Taiye24/Final-Year-Mechatronics-Project-478/TESTING/WETTED AREA/Wetted_Area_Test_Data_LCG560.xlsx

Sheet: Model dimensions
Model dimensions
Quantity | Value | Unit
Beam (chine) | 400 | mm
Planing length | 1600 | mm
Deadrise angle | 18 | deg
Displacement weight | 264.87 | N
Displacement mass | 27 | kg
LCG from transom (resistance and wetted-area tests) | 560 | mm
VCG above keel | 92 | mm
Tow-rod (thrust line) height above keel | 161.6 | mm
Thrust-line offset from CG (negative = above CG) | -69.6 | mm
Thrust inclination to keel | 0 | deg

Sheet: Resistance tests
Drag and trim, LCG 560 mm from transom: resistance tests (clean hull, water temperature 16.8 °C)
Run | Mean speed (m/s) | Volumetric Froude number | Drag (N) | Running trim (deg)
1 | 0.390 | 0.23 | 0.77 | 3.25
2 | 0.904 | 0.53 | 5.43 | 3.43
3 | 1.421 | 0.83 | 15.96 | 3.96
4 | 1.937 | 1.13 | 31.12 | 5.70
5 | 2.454 | 1.43 | 37.85 | 6.45
6 | 2.965 | 1.73 | 41.39 | 6.78
7 | 3.483 | 2.03 | 45.95 | 7.26
8 | 3.999 | 2.33 | 47.71 | 7.47
9 | 4.512 | 2.63 | 47.79 | 7.06
10 | 5.024 | 2.93 | 48.21 | 6.50
11 | 5.541 | 3.23 | 48.70 | 5.95
12 | 6.057 | 3.53 | 49.99 | 5.47
13 | 6.569 | 3.83 | 51.38 | 5.02
Values used
Displacement weight (N) | 264.87
Water density at 16.8 °C (kg/m³) | 998.8125 | ITTC 7.5-02-01-03 (2011)
Static floating trim (deg) | 3.2

Sheet: Wetted area tests
Wetted area, LCG 560 mm from transom (water temperature 19 °C), with drag and trim from the resistance tests (16.8 °C) at the same speed
Run | Mean speed (m/s) | Volumetric Froude number | Drag from resistance tests (N) | Running trim from resistance tests (deg) | Wetted keel length (m) | Wetted chine length (m) | Mean wetted length (m) | Rectangle b·Lc (m²) | Triangles ½b(Lk − Lc) (m²) | Plan-view wetted area (m²) | Wetted surface area (m²)
1 | 2.041 | 1.19 | 32.47 | 5.85 | 1.585 | 1.365 | 1.475 | 0.546 | 0.044 | 0.590 | 0.620
2 | 3.069 | 1.79 | 42.31 | 6.88 | 1.420 | 1.065 | 1.242 | 0.426 | 0.071 | 0.497 | 0.523
3 | 4.104 | 2.39 | 47.73 | 7.38 | 1.175 | 0.845 | 1.010 | 0.338 | 0.066 | 0.404 | 0.425
4 | 5.132 | 2.99 | 48.31 | 6.39 | 1.050 | 0.730 | 0.890 | 0.292 | 0.064 | 0.356 | 0.374
Values used
Displacement weight (N) | 264.87
Water density at 19 °C (kg/m³) | 998.4083 | ITTC 7.5-02-01-03 (2011)
Beam (m) | 0.4
Deadrise angle (deg) | 18
