Taiye24/Final-Year-Mechatronics-Project-478/SAMPLE CALCULATIONS/Calculations_Chapters_4_and_5.xlsx

Sheet: Inputs
Inputs, water properties and uncertainty parameters
Blue = input value (source in column D); black = formula.
Quantity | Value | Unit | Source
Displacement weight, W | 264.87 | N | Data_Eval workbooks, ANALYZE DATA!B33
Gravitational acceleration, g | 9.81 | m/s² | As used in the Data_Eval workbooks
Water temperature, 640 mm (Sets A–C, same day) | 15.8 | °C | Measured during testing
Water temperature, 560 and 480 mm | 16.8 | °C | Measured during testing
ITTC 7.5-02-01-03 Rev 02 (2011), Appendix A: fresh water properties used
Temperature (°C) | ρ (kg/m³) | ν (m²/s)
15.8 | 998.9783 | 1.115e-06 | ITTC 7.5-02-01-03 Rev 02 (2011), Appendix A (0.1 °C increments)
16.8 | 998.8125 | 1.0867e-06
19 | 998.4083 | 1.0283e-06
Quantity | 640 mm | 560 and 480 mm | Unit
Water density, ρ (ITTC 2011) | 998.98 | 998.81 | kg/m³
Displaced volume, ∇ = W/(ρg) (Equation 4.2) | 0.027028 | 0.027032 | m³
∇^(1/3) | 0.30010 | 0.30012 | m
Reference speed, √(g∇^(1/3)) (denominator of Equation 4.1) | 1.71581 | 1.71586 | m/s
Uncertainty inputs (Figliola & Beasley, 2019; Equations 4.5 and 4.6)
Quantity | Value | Unit | Source
Number of repeat sets, N | 3 |  | Sets A–C (Table 4.3)
Student's t, 95 %, two degrees of freedom, t95 | 4.303 |  | Student t table, ν = N − 1 = 2
Systematic term, drag | 0 | N | No confirmed load-cell accuracy (Section 4.11)
Potentiometer resolution (P25 variant) | 0.2 | mm | Micro-Epsilon (n.d.)
Attachment spacing, dpot | 1690 | mm | Data_Eval_640.xls, ANALYZE DATA!B10
Systematic term, trim: half resolution per potentiometer through Equation 4.3 | 0.0048 | deg | Calculated
Check: density to use inside the Data_Eval workbooks (ITTC 2011)
Workbook | ρ used (kg/m³) | Effect on Fn∇ | Note
Data_Eval_640.xls | 998.9783 | 0.000%
Data_Eval_560.xls and Data_Eval_480.xls | 998.8125 | 0.000%

Sheet: Table 4.4
Table 4.4: Test speeds and volumetric Froude numbers (Equation 4.1, 15.8 °C water)
V (m/s) | Fn∇ | Fn∇ as printed in Table 4.4
0.5 | 0.2914 | 0.29
1.0 | 0.5828 | 0.58
1.5 | 0.8742 | 0.87
2.0 | 1.1656 | 1.17
2.5 | 1.4570 | 1.46
3.0 | 1.7484 | 1.75
3.5 | 2.0399 | 2.04
4.0 | 2.3313 | 2.33
4.5 | 2.6227 | 2.62
5.0 | 2.9141 | 2.91
5.5 | 3.2055 | 3.21
6.0 | 3.4969 | 3.50
6.5 | 3.7883 | 3.79
Speeds are the nominal (target) test speeds; the reference speed √(g∇^(1/3)) is on the Inputs sheet.

Sheet: Table F.1
Appendix Table F.1: baseline results at LCG 640 mm, mean of three sets ± uₓ at 95 % confidence
Blue columns: measured run means from Data_Eval_640.xls, ANALYZE DATA. Speed and drag are the numbers inside the Fn∇ and D/W formulas (rows 2–3, 26–27, 49–50); trim is rows 4, 28 and 51. All other columns are formulas.
 | Speed |  |  |  |  | Drag force (N) |  |  |  |  |  |  | Running trim (deg) |  |  |  |  |  |  | As printed in Table F.1
Step | V Set A (m/s) | V Set B (m/s) | V Set C (m/s) | Mean V (m/s) | Fn∇ | F Set A | F Set B | F Set C | Mean F | s | s / √N | uₓ (95 %) | τ Set A | τ Set B | τ Set C | Mean τ | s | s / √N | uₓ (95 %) | V (m/s) | Fn∇ | F (N) | τ (deg) | u_F / mean F (%)
1 | 0.4043 | 0.4098 | 0.4115 | 0.4085 | 0.2381 | 1.3231 | 0.9258 | 0.9367 | 1.0619 | 0.2263 | 0.1307 | 0.5622 | 2.3132 | 2.2065 | 2.2212 | 2.2470 | 0.0578 | 0.0334 | 0.1450 | 0.41 | 0.24 | 1.1 ± 0.6 | 2.25 ± 0.15 | 52.9
2 | 0.9187 | 0.9242 | 0.9257 | 0.9229 | 0.5379 | 5.0563 | 4.9405 | 4.9252 | 4.9740 | 0.0717 | 0.0414 | 0.1781 | 2.4040 | 2.2952 | 2.2730 | 2.3241 | 0.0701 | 0.0405 | 0.1753 | 0.92 | 0.54 | 5.0 ± 0.2 | 2.32 ± 0.18 | 3.6
3 | 1.4358 | 1.4412 | 1.4425 | 1.4398 | 0.8392 | 16.7992 | 16.5038 | 16.1236 | 16.4755 | 0.3387 | 0.1955 | 0.8414 | 2.7904 | 2.6179 | 2.5887 | 2.6657 | 0.1090 | 0.0629 | 0.2716 | 1.44 | 0.84 | 16.5 ± 0.8 | 2.67 ± 0.27 | 5.1
4 | 1.9516 | 1.9568 | 1.9588 | 1.9558 | 1.1398 | 28.5617 | 28.6132 | 28.6007 | 28.5919 | 0.0269 | 0.0155 | 0.0667 | 3.9469 | 3.9193 | 3.9171 | 3.9278 | 0.0166 | 0.0096 | 0.0461 | 1.96 | 1.14 | 28.6 ± 0.1 | 3.93 ± 0.05 | 0.2
5 | 2.4692 | 2.4744 | 2.4763 | 2.4733 | 1.4415 | 32.3070 | 32.2677 | 32.2184 | 32.2644 | 0.0444 | 0.0256 | 0.1102 | 4.7337 | 4.6691 | 4.6586 | 4.6872 | 0.0407 | 0.0235 | 0.1031 | 2.47 | 1.44 | 32.3 ± 0.1 | 4.69 ± 0.10 | 0.3
6 | 2.9795 | 2.9844 | 2.9843 | 2.9827 | 1.7384 | 34.3302 | 34.9652 | 34.1179 | 34.4711 | 0.4409 | 0.2545 | 1.0953 | 4.9482 | 5.0273 | 4.8849 | 4.9535 | 0.0713 | 0.0412 | 0.1784 | 2.98 | 1.74 | 34.5 ± 1.1 | 4.95 ± 0.18 | 3.2
7 | 3.4980 | 3.5019 | 3.5034 | 3.5011 | 2.0405 | 37.3415 | 37.1061 | 37.0320 | 37.1599 | 0.1616 | 0.0933 | 0.4015 | 5.0720 | 4.9879 | 4.9784 | 5.0127 | 0.0515 | 0.0297 | 0.1296 | 3.50 | 2.04 | 37.2 ± 0.4 | 5.01 ± 0.13 | 1.1
8 | 4.0153 | 4.0185 | 4.0208 | 4.0182 | 2.3419 | 40.8890 | 40.9051 | 40.5652 | 40.7865 | 0.1918 | 0.1107 | 0.4764 | 5.3777 | 5.3347 | 5.2863 | 5.3329 | 0.0457 | 0.0264 | 0.1155 | 4.02 | 2.34 | 40.8 ± 0.5 | 5.33 ± 0.12 | 1.2
9 | 4.5327 | 4.5365 | 4.5379 | 4.5357 | 2.6435 | 43.4287 | 43.1846 | 43.2343 | 43.2825 | 0.1290 | 0.0745 | 0.3205 | 5.6104 | 5.5465 | 5.5729 | 5.5766 | 0.0321 | 0.0185 | 0.0824 | 4.54 | 2.64 | 43.3 ± 0.3 | 5.58 ± 0.08 | 0.7
10 | 5.0428 | 5.0456 | 5.0479 | 5.0454 | 2.9406 | 45.7178 | 45.3184 | 45.1735 | 45.4032 | 0.2819 | 0.1627 | 0.7003 | 5.4191 | 5.3599 | 5.3662 | 5.3817 | 0.0325 | 0.0188 | 0.0833 | 5.05 | 2.94 | 45.4 ± 0.7 | 5.38 ± 0.08 | 1.5
11 | 5.5583 | 5.5596 | 5.5613 | 5.5597 | 3.2403 | 47.5239 | 47.3430 | 47.0145 | 47.2938 | 0.2582 | 0.1491 | 0.6415 | 5.1109 | 5.0925 | 5.0422 | 5.0819 | 0.0356 | 0.0205 | 0.0908 | 5.56 | 3.24 | 47.3 ± 0.6 | 5.08 ± 0.09 | 1.4
12 | 6.0718 | 6.0761 | 6.0775 | 6.0751 | 3.5407 | 49.8011 | 49.7258 | 49.6173 | 49.7147 | 0.0924 | 0.0534 | 0.2296 | 4.7872 | 4.7322 | 4.7318 | 4.7504 | 0.0319 | 0.0184 | 0.0818 | 6.08 | 3.54 | 49.7 ± 0.2 | 4.75 ± 0.08 | 0.5
13 | 6.5844 | 6.5903 | 6.5906 | 6.5884 | 3.8398 | 52.7014 | 52.6329 | 52.1319 | 52.4887 | 0.3109 | 0.1795 | 0.7724 | 4.4814 | 4.4593 | 4.4116 | 4.4507 | 0.0357 | 0.0206 | 0.0910 | 6.59 | 3.84 | 52.5 ± 0.8 | 4.45 ± 0.09 | 1.5

Sheet: Wetted area 560
Wetted lengths and area at LCG 560 mm: measured (coating wash-off) and Savitsky (1964) prediction
Blue = input (measured values from the wash-off runs; predictions from Savitsky_Wetted_Area.m). Black = formula.
Beam, b | 0.4 | m | Table 4.1
Deadrise angle, β | 18 | deg | Table 4.1
Water temperature | 19 | °C | Measured, wetted-area runs
ITTC (2011) density at 19 °C | 998.41 | kg/m³ | ITTC 7.5-02-01-03 Rev 02 (2011), Appendix A
Water density, ρ | 998.41 | kg/m³ | Formula
Reference speed, √(g∇^(1/3)) | 1.71597 | m/s | Equations 4.1 and 4.2
Run | V (m/s) | Lk meas. (m) | Lc meas. (m) | Mean wetted length (m) | λ meas. | Plan-view area A = b·Lc + ½b(Lk − Lc) (m²) | Wetted surface S (m²) | Fn∇ | λ pred. | Lk pred. (m) | Lc pred. (m) | λ error, Eq. 5.1 (%) | Lk error, Eq. 5.1 (%) | Lc error, Eq. 5.1 (%) | S pred. (m²)
1 | 2.0409 | 1.585 | 1.365 | 1.4750 | 3.6875 | 0.5900 | 0.6204 | 1.19 | 3.5991 | 1.6701 | 1.2092 | -+2.4 | +5.4 | -+11.4 | 0.6055
2 | 3.0688 | 1.420 | 1.065 | 1.2425 | 3.1062 | 0.4970 | 0.5226 | 1.79 | 2.9120 | 1.3458 | 0.9838 | -+6.3 | -+5.2 | -+7.6 | 0.4899
3 | 4.1041 | 1.175 | 0.845 | 1.0100 | 2.5250 | 0.4040 | 0.4248 | 2.39 | 2.4474 | 1.1563 | 0.8016 | -+3.1 | -+1.6 | -+5.1 | 0.4117
4 | 5.1323 | 1.050 | 0.730 | 0.8900 | 2.2250 | 0.3560 | 0.3743 | 2.99 | 2.2376 | 1.0997 | 0.6904 | +0.6 | +4.7 | -+5.4 | 0.3764
Mean absolute λ error (%) |  |  |  |  |  |  |  |  |  |  |  | 3.1
A = b(Lk + Lc)/2 and S = A/cos β (Equations 4.7 and 4.8); λ = (Lk + Lc)/(2b) (Equation 5.3).

Sheet: Ch4 other calcs
Chapter 4: remaining calculations (blue = input with source; black = formula)
Mass and ballast (§4.7.1)
Displaced mass, Δ/g | 27.00 | kg | Formula
Bare hull mass | 11.99 | kg | Scale reading
Ballast needed | 15.01 | kg | Formula
Trim reduction of one run (Equation 4.3): 2.47 m/s, window 14.0–26.0 s
Mean bow reading | -37.79252652 | mm | Data_Eval_640.xls, live block
Mean stern reading | 36.952457 | mm | Data_Eval_640.xls, live block
Running trim τ = τ₀ + atan((−bow − (−stern))/dpot) | 4.7324 | deg | τ₀ = 2.2° (Table 4.3)
Signal-to-noise ratio and standard error (§4.6): 2.47 m/s run, 14.0–26.0 s
Signal | Mean | Standard deviation | Samples | Signal-to-noise ratio | Standard error of mean
Speed (m/s) | 2.4686 | 0.0184 | 3600 | 133.8 | 0.0003
Drag (N) | 32.2853 | 0.6291 | 3600 | 51.3 | 0.0105
Bow displacement (mm) | 37.7925 | 0.7816 | 3600 | 48.4 | 0.0130
Stern displacement (mm) | 36.9525 | 0.7566 | 3600 | 48.8 | 0.0126
Source: Data_Eval_640.xls RAW DATA, 14.0 ≤ t ≤ 26.0 s
Drag standard error / set-to-set s at 2.47 m/s | 0.24 |  | Formula
Potentiometer linearity propagated to trim (§4.11)
P25 linearity error, 0.25 % of 750 mm | 1.875 | mm | Micro-Epsilon (n.d.)
P25 trim bound B = √2·e/dpot | 0.0899 | deg | Formula
P25 standard uncertainty B/2 | 0.0449 | deg | Formula
P10 linearity error, 0.1 % of 750 mm | 0.750 | mm | Micro-Epsilon (n.d.)
P10 trim bound B = √2·e/dpot | 0.0360 | deg | Formula
P10 standard uncertainty B/2 | 0.0180 | deg | Formula
Load-cell range used (§4.11)
Largest mean drag (480 mm, 3.48 m/s) | 57.52347569 | N | Data_Eval_480.xls
Percentage of 490.5 N capacity | 11.7 | % | Formula
Reynolds number and laminar length (§4.11, Equation 4.4): water at 15.8 °C
Kinematic viscosity (ITTC 2011, 15.8 °C) | 1.115e-06 | m²/s | ITTC 7.5-02-01-03 Rev 02 (2011), Appendix A
Reynolds number at 0.41 m/s, V·Lp/ν | 588340.8072 |  | Formula
Reynolds number at 6.59 m/s, V·Lp/ν | 9456502.242 |  | Formula
Laminar length at 0.41 m/s, 5×10⁵ν/V | 1.360 | m | Formula
Laminar length at 2 m/s, 5×10⁵ν/V | 0.279 | m | Formula
Laminar length at 6.5 m/s, 5×10⁵ν/V | 0.086 | m | Formula
Trim-dependent drag term at each trim peak (§4.13): Δ tan τ / D
LCG | Trim peak (deg) | Drag at the peak (N) | Δ tan τ (N) | Share of drag (%)
640 mm | 5.5766 | 43.2825 | 25.86 | 59.8
560 mm | 7.4695 | 47.7121 | 34.73 | 72.8
480 mm | 9.8768 | 57.5235 | 46.12 | 80.2
Source: Data_Eval workbooks (640 mm is the mean of three sets)

Sheet: Ch5 comparison
Chapter 5: prediction errors (Equation 5.1) and mean absolute errors (Equation 5.2)
Blue: measured values (Data_Eval workbooks) and predictions (Savitsky_Code_Test_m_Factor_All.m output). Black: formulas.
LCG | Fn∇ | D/Δ meas. | τ meas. (deg) | D/Δ Savitsky | M | τ pred. (deg) | D/Δ Sav. + M | e Savitsky (%) | e Sav. + M (%) | e trim (%) | Trim offset (deg)
640 mm | 1.74 | 0.1301 | 4.95 | 0.1175 | 1.315 | 4.49 | 0.1544 | -+9.7 | +18.7 | -+9.3 | -+0.46
640 mm | 2.04 | 0.1403 | 5.01 | 0.1342 | 1.211 | 4.93 | 0.1625 | -+4.3 | +15.8 | -+1.6 | -+0.08
640 mm | 2.34 | 0.1540 | 5.33 | 0.1472 | 1.125 | 5.14 | 0.1657 | -+4.4 | +7.6 | -+3.6 | -+0.19
640 mm | 2.64 | 0.1634 | 5.58 | 0.1567 | 1.067 | 5.10 | 0.1672 | -+4.1 | +2.3 | -+8.6 | -+0.48
640 mm | 2.94 | 0.1714 | 5.38 | 0.1642 | 1.031 | 4.88 | 0.1693 | -+4.2 | -+1.2 | -+9.3 | -+0.50
640 mm | 3.24 | 0.1786 | 5.08 | 0.1716 | 1.009 | 4.58 | 0.1732 | -+3.9 | -+3.0 | -+9.9 | -+0.50
640 mm | 3.54 | 0.1877 | 4.75 | 0.1799 | 0.997 | 4.25 | 0.1793 | -+4.1 | -+4.5 | -+10.6 | -+0.50
640 mm | 3.84 | 0.1982 | 4.45 | 0.1896 | 0.989 | 3.93 | 0.1876 | -+4.3 | -+5.4 | -+11.7 | -+0.52
LCG | Fn∇ | D/Δ meas. | τ meas. (deg) | D/Δ Savitsky | M | τ pred. (deg) | D/Δ Sav. + M | e Savitsky (%) | e Sav. + M (%) | e trim (%) | Trim offset (deg)
560 mm | 1.13 | 0.1175 | 5.70 | 0.1048 | 1.026 | 4.99 | 0.1075 | -+10.8 | -+8.5 | -+12.4 | -+0.71
560 mm | 1.43 | 0.1429 | 6.45 | 0.1248 | 1.264 | 5.72 | 0.1578 | -+12.7 | +10.4 | -+11.4 | -+0.74
560 mm | 1.73 | 0.1563 | 6.78 | 0.1441 | 1.241 | 6.41 | 0.1788 | -+7.8 | +14.4 | -+5.6 | -+0.38
560 mm | 2.03 | 0.1735 | 7.26 | 0.1578 | 1.166 | 6.78 | 0.1840 | -+9.0 | +6.0 | -+6.7 | -+0.49
560 mm | 2.33 | 0.1801 | 7.47 | 0.1646 | 1.099 | 6.71 | 0.1809 | -+8.6 | +0.4 | -+10.2 | -+0.76
560 mm | 2.63 | 0.1804 | 7.06 | 0.1673 | 1.053 | 6.35 | 0.1761 | -+7.3 | -+2.4 | -+10.0 | -+0.71
560 mm | 2.93 | 0.1820 | 6.50 | 0.1692 | 1.023 | 5.87 | 0.1730 | -+7.1 | -+4.9 | -+9.6 | -+0.63
560 mm | 3.23 | 0.1839 | 5.95 | 0.1718 | 1.005 | 5.37 | 0.1726 | -+6.6 | -+6.1 | -+9.7 | -+0.58
560 mm | 3.53 | 0.1887 | 5.47 | 0.1760 | 0.994 | 4.90 | 0.1750 | -+6.7 | -+7.3 | -+10.5 | -+0.57
560 mm | 3.83 | 0.1940 | 5.02 | 0.1821 | 0.988 | 4.47 | 0.1799 | -+6.1 | -+7.2 | -+11.0 | -+0.55
LCG | Fn∇ | D/Δ meas. | τ meas. (deg) | D/Δ Savitsky | M | τ pred. (deg) | D/Δ Sav. + M | e Savitsky (%) | e Sav. + M (%) | e trim (%) | Trim offset (deg)
480 mm | 1.13 | 0.1557 | 7.69 | 0.1455 | 0.910 | 7.47 | 0.1324 | -+6.5 | -+15.0 | -+2.9 | -+0.23
480 mm | 1.43 | 0.1836 | 8.53 | 0.1709 | 1.164 | 8.59 | 0.1989 | -+6.9 | +8.3 | +0.7 | +0.06
480 mm | 1.70 | 0.1973 | 9.45 | 0.1875 | 1.174 | 9.24 | 0.2202 | -+5.0 | +11.6 | -+2.2 | -+0.21
480 mm | 2.03 | 0.2172 | 9.88 | 0.1924 | 1.122 | 9.15 | 0.2158 | -+11.4 | -+0.6 | -+7.4 | -+0.73
480 mm | 2.33 | 0.2113 | 9.16 | 0.1884 | 1.072 | 8.52 | 0.2020 | -+10.8 | -+4.4 | -+6.9 | -+0.63
480 mm | 2.63 | 0.2017 | 8.29 | 0.1825 | 1.037 | 7.75 | 0.1893 | -+9.5 | -+6.2 | -+6.5 | -+0.54
480 mm | 2.93 | 0.1947 | 7.51 | 0.1776 | 1.014 | 6.95 | 0.1801 | -+8.7 | -+7.5 | -+7.4 | -+0.56
480 mm | 3.23 | 0.1921 | 6.76 | 0.1751 | 1.000 | 6.24 | 0.1750 | -+8.8 | -+8.9 | -+7.8 | -+0.53
480 mm | 3.52 | 0.1954 | 6.42 | 0.1750 | 0.991 | 5.61 | 0.1735 | -+10.4 | -+11.2 | -+12.5 | -+0.80
480 mm | 3.83 | 0.1910 | 5.68 | 0.1775 | 0.986 | 5.05 | 0.1750 | -+7.1 | -+8.4 | -+11.1 | -+0.63
Table 5.2: mean absolute errors
LCG | Points compared | Savitsky drag MAE (%) | Savitsky + M-factor drag MAE (%) | Trim MAE (%) | Mean trim offset (deg)
640 mm | 8 | 4.9 | 7.3 | 8.1 | -+0.41
560 mm | 10 | 8.3 | 6.8 | 9.7 | -+0.61
480 mm | 10 | 8.5 | 8.2 | 6.5 | -+0.48
