Taiye24/Final-Year-Mechatronics-Project-478/SAMPLE CALCULATIONS/ITTC1957_50m_Vessel.xlsx

Sheet: Inputs
ITTC 1957 method (Bertram, Practical Ship Hydrodynamics, Section 3.2.3): 50 m vessel from the LCG 560 mm model tests
Quantity | Value | Unit | Source
Model beam, b | 0.4 | m
Deadrise angle, β | 18 | deg
Model planing length, Lp,m | 1.6 | m
Model displacement weight, Δm | 264.87 | N
Gravitational acceleration, g | 9.81 | m/s²
Model water density, clean resistance runs (16.8 °C), ρm | 998.8125 | kg/m³ | ITTC 7.5-02-01-03 (2011)
Model water kinematic viscosity (16.8 °C), νm | 1.0867e-06 | m²/s | ITTC 7.5-02-01-03 (2011)
Vessel length, Ls | 50 | m
Scale factor, SF = Ls / Lp,m | 31.250 | – | Length scales with SF
Sea water density, ρs | 1026 | kg/m³
Sea water dynamic viscosity, μs | 0.00122 | Pa·s
Sea water kinematic viscosity, νs = μs / ρs | 1.189083821e-06 | m²/s
Correlation allowance, cA = 0.35×10⁻³ − 2 Ls×10⁻⁶ | 0.00025 | – | Bertram Eq. 3.19
Model displaced volume, ∇m = Δm / (ρm g) | 0.027032 | m³
Vessel displaced volume, ∇s = SF³ ∇m | 825.0 | m³ | Volume scales with SF³
Vessel displacement, Δs = ρs g ∇s | 8303.2 | kN
Water density, wetted-area runs (19.0 °C), for their Fr | 998.4083 | kg/m³ | ITTC 7.5-02-01-03 (2011)

Sheet: Wetted area regression
Wetted-area runs, LCG 560 mm (water at 19.0 °C): regressions of wetted surface (2nd-order polynomial) and wetted keel length (linear) on Fr
Run | V (m/s) | Fr (Fn∇, 19.0 °C) | Fr² | Lk (m) | Lc (m) | Rectangle b·Lc (m²) | Triangles ½b(Lk − Lc) (m²) | Plan-view area A (m²) | Wetted surface S = A / cos β (m²)
1 | 2.0409 | 1.1894 | 1.4146 | 1.585 | 1.365 | 0.5460 | 0.0440 | 0.5900 | 0.6204
2 | 3.0688 | 1.7884 | 3.1984 | 1.420 | 1.065 | 0.4260 | 0.0710 | 0.4970 | 0.5226
3 | 4.1041 | 2.3917 | 5.7203 | 1.175 | 0.845 | 0.3380 | 0.0660 | 0.4040 | 0.4248
4 | 5.1323 | 2.9909 | 8.9454 | 1.050 | 0.730 | 0.2920 | 0.0640 | 0.3560 | 0.3743
S(Fr) = a0 + a1 Fr + a2 Fr²
a0 | 0.905049
a1 | -0.276489
a2 | 0.032855
R² | 0.9970
Lk(Fr) = c0 + c1 Fr
c0 | 1.951194
c1 | -0.307974
R² | 0.9865

Sheet: ITTC 1957 50 m vessel
Run | V (m/s) | RTm (N) | Fr (Fn∇) | Sm (m²) | Lk,m (m) | Rn,m (keel length) | cTm (Eq. 5.5) | cFm (Eq. 5.6) | cR (Eq. 5.8) | Vs (m/s) | Vs (knots) | Lk,s (m) | Ss (m²) | Rn,s (keel length) | cFs (Eq. 5.6) | cTs (Eq. 5.9) | RTs = thrust (kN) (Eq. 5.10)
1 | 0.3900 | 0.774 | 0.23 | 0.8439 | 1.881 | 675054.788 | 0.01208 | 0.00511 | 0.00697 | 2.18 | 4.2 | 58.79 | 824.1 | 107773317.5 | 0.00206 | 0.00928 | 18.6
2 | 0.9045 | 5.432 | 0.53 | 0.7684 | 1.789 | 1488877.373 | 0.01730 | 0.00431 | 0.01299 | 5.06 | 9.8 | 55.90 | 750.4 | 237701082.5 | 0.00184 | 0.01509 | 148.5
3 | 1.4215 | 15.962 | 0.83 | 0.6985 | 1.696 | 2218562.313 | 0.02264 | 0.00397 | 0.01867 | 7.95 | 15.4 | 53.00 | 682.2 | 354196170.1 | 0.00175 | 0.02067 | 456.8
4 | 1.9374 | 31.118 | 1.13 | 0.6348 | 1.603 | 2858672.562 | 0.02615 | 0.00378 | 0.02238 | 10.83 | 21.1 | 50.11 | 619.9 | 456390549.5 | 0.00169 | 0.02432 | 907.0
5 | 2.4539 | 37.854 | 1.43 | 0.5768 | 1.511 | 3411498.375 | 0.02182 | 0.00365 | 0.01817 | 13.72 | 26.7 | 47.21 | 563.3 | 544649862.6 | 0.00165 | 0.02007 | 1091.6
6 | 2.9652 | 41.395 | 1.73 | 0.5254 | 1.419 | 3871908.176 | 0.01794 | 0.00356 | 0.01438 | 16.58 | 32.2 | 44.34 | 513.0 | 618154847 | 0.00163 | 0.01626 | 1175.7
7 | 3.4832 | 45.951 | 2.03 | 0.4792 | 1.326 | 4250217.015 | 0.01583 | 0.00350 | 0.01233 | 19.47 | 37.8 | 41.44 | 467.9 | 678552313 | 0.00161 | 0.01418 | 1290.9
8 | 3.9994 | 47.712 | 2.33 | 0.4391 | 1.233 | 4539155.193 | 0.01360 | 0.00346 | 0.01014 | 22.36 | 43.5 | 38.54 | 428.8 | 724681644.4 | 0.00159 | 0.01199 | 1318.2
9 | 4.5119 | 47.787 | 2.63 | 0.4052 | 1.141 | 4738881.007 | 0.01160 | 0.00343 | 0.00817 | 25.22 | 49.0 | 35.67 | 395.7 | 756568113.4 | 0.00159 | 0.01000 | 1292.0
10 | 5.0240 | 48.207 | 2.93 | 0.3772 | 1.049 | 4851801.701 | 0.01014 | 0.00342 | 0.00672 | 28.09 | 54.6 | 32.80 | 368.3 | 774596039.5 | 0.00158 | 0.00855 | 1274.9
11 | 5.5409 | 48.698 | 3.23 | 0.3548 | 0.957 | 4877926.553 | 0.00895 | 0.00341 | 0.00554 | 30.97 | 60.2 | 29.90 | 346.5 | 778766903.9 | 0.00158 | 0.00737 | 1256.6
12 | 6.0570 | 49.992 | 3.53 | 0.3384 | 0.864 | 4815956.669 | 0.00806 | 0.00342 | 0.00464 | 33.86 | 65.8 | 27.00 | 330.5 | 768873336.5 | 0.00158 | 0.00647 | 1258.3
13 | 6.5691 | 51.380 | 3.83 | 0.3281 | 0.772 | 4667512.215 | 0.00727 | 0.00344 | 0.00383 | 36.72 | 71.4 | 24.13 | 320.4 | 745173999 | 0.00159 | 0.00566 | 1255.5
