Taiye24/Final-Year-Mechatronics-Project-478/(list of files, cad)

Other CAD files:
CAD FILES/CIRCULAR BOARD 6mm.dwg
CAD FILES/BOW ASSEMBLY.iam
CAD FILES/BOW DESIGN 2.ipt
CAD FILES/BOW DESIGN 3.ipt
CAD FILES/BOW DESIGN LEFT SIDE.ipt
CAD FILES/BOW DESIGN RIGHT SIDE.ipt
CAD FILES/BOW DESIGN TWO PARTS.iam
CAD FILES/BOW DESIGN.ipt
CAD FILES/BOW SECTION 3D PRINTED.idw
CAD FILES/BOW_SECTION 3D PRINTED.idw
CAD FILES/Ballast Weights.ipt
CAD FILES/Boat Rev 1.ipt
CAD FILES/Bow Plate.idw
CAD FILES/Bow_Tansform_Plate.ipt
CAD FILES/Bow_Tansform_Plate_No_Holes.ipt
CAD FILES/CIRCULAR BOARD 6mm.ipt
CAD FILES/CIRCULAR WOODEN BOARD.ipt
CAD FILES/Circular Board 6mm.idw
CAD FILES/Circular Board.idw
CAD FILES/Higher_Section_Plate.idw
CAD FILES/Higher_Section_Plate.ipt
CAD FILES/Higher_Section_Plate2.ipt
CAD FILES/Higher_Section_Plate_MIR.ipt
CAD FILES/Higher_Section_Plate_Mirrored.idw
CAD FILES/Hull_Section.ipn
CAD FILES/LEFT SIDE BOW 3D PRINTED.idw
CAD FILES/Low_Section_Plate.ipt
CAD FILES/Low_Section_Plate_MIR.ipt
CAD FILES/Low_Section_Plate_MIR1.ipt
CAD FILES/Low_Section_Plate_MIR2.ipt
CAD FILES/Lower_Section_Plate.idw
CAD FILES/Lower_Section_Plate_Mirrored.idw
CAD FILES/PART A.ipt
CAD FILES/PART B.ipt
CAD FILES/PLANING HULL ASSEMBLY.idw
CAD FILES/Planning_Hull_Section.iam
CAD FILES/Planning_Hull_Section.iam.ipn
CAD FILES/RIB.ipt
CAD FILES/RIGHT SIDE BOW 3D PRINTED.idw
CAD FILES/Rib 18mm.idw
CAD FILES/Rib 6mm.idw
CAD FILES/Steel Rod.idw
CAD FILES/Steel Rod.ipt
CAD FILES/Transform Plate.idw
CAD FILES/WOODEN RIB.ipt
