Taiye24/Final-Year-Mechatronics-Project-478/TESTING/LCG 480/Test1_2.XLSX

File comment:
Time 1 - default sample rate | Velocity | Drag Force | Bow Trim | Stern Trim | MX840B_CH 5 | MX840B_CH 6 | MX840B_CH 7 | MX840B_CH 8
s | m/s | N | mm | mm | V | V | V | V
24.09.26 15:55:46 | 24.09.26 15:55:46 | 24.09.26 15:55:46 | 24.09.26 15:55:46 | 24.09.26 15:55:46 | 24.09.26 15:55:46 | 24.09.26 15:55:46 | 24.09.26 15:55:46 | 24.09.26 15:55:46
3,33 ms (300 Hz) | 3,33 ms (300 Hz) | 3,33 ms (300 Hz) | 3,33 ms (300 Hz) | 3,33 ms (300 Hz) | 3,33 ms (300 Hz) | 3,33 ms (300 Hz) | 3,33 ms (300 Hz) | 3,33 ms (300 Hz)
Hardware channel:0 | Hardware channel:1 | Hardware channel:2 | Hardware channel:3 | Hardware channel:4 | Hardware channel:5 | Hardware channel:6 | Hardware channel:7 | Hardware channel:8
Serial No. (Electronics / CP): N.A. | Serial No. (Electronics / CP): 9E5012BF0 | Serial No. (Electronics / CP): 9E5012BF0 | Serial No. (Electronics / CP): 9E5012BF0 | Serial No. (Electronics / CP): 9E5012BF0 | Serial No. (Electronics / CP): 9E5012BF0 | Serial No. (Electronics / CP): 9E5012BF0 | Serial No. (Electronics / CP): 9E5012BF0 | Serial No. (Electronics / CP): 9E5012BF0
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
