Taiye24/Final-Year-Mechatronics-Project-478/CAD FILES/BOW SECTION 3D PRINTED.pdf

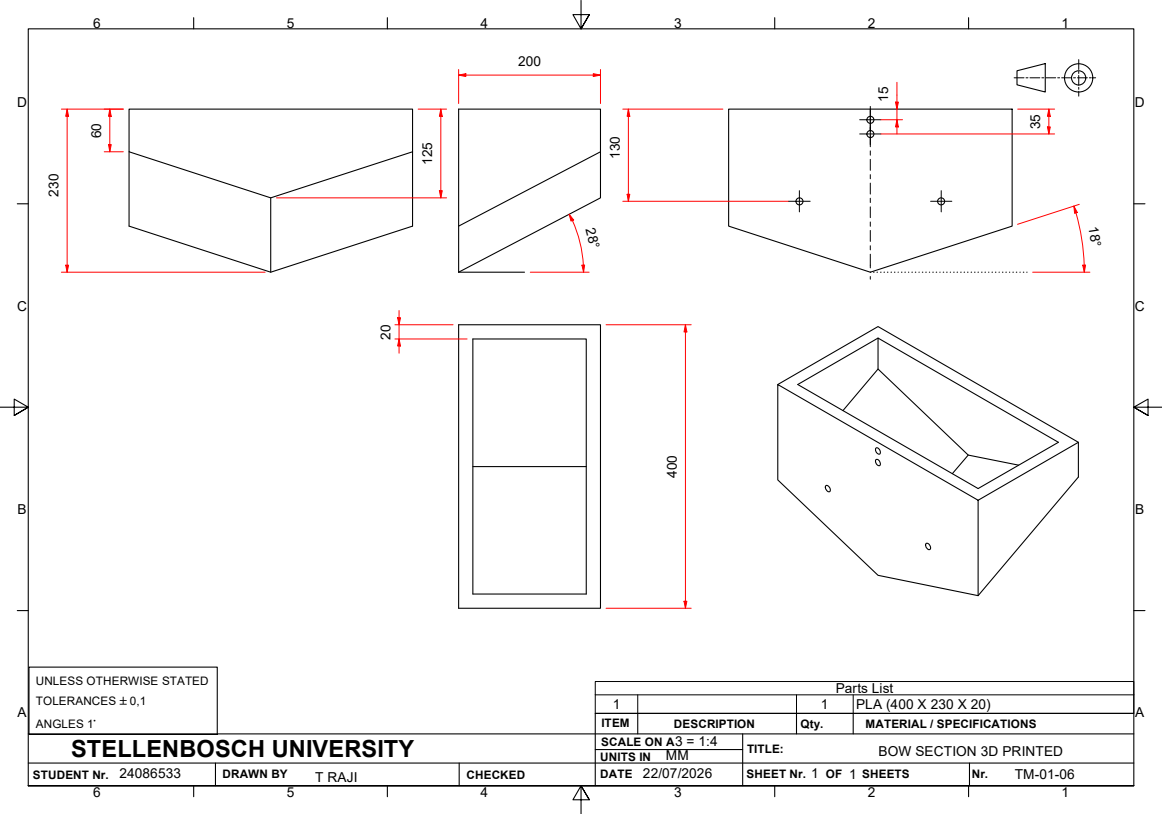
[picture p1: page 1]
Parts List; STUDENT Nr.; DRAWN BY; CHECKED; SCALE ON A UNITS IN; SHEET Nr.; SHEETS; T RAJI; BOW SECTION 3D PRINTED

UNLESS OTHERWISE STATED
TOLERANCES `0,1
ANGLES 1~
STELLENBOSCH UNIVERSITY

1 | | 1 | PLA (400 X 230 X 20)
ITEM | DESCRIPTION | Qty. | MATERIAL / SPECIFICATIONS
