Taiye24/Final-Year-Mechatronics-Project-478/CAD FILES/LEFT SIDE BOW 3D PRINTED.pdf

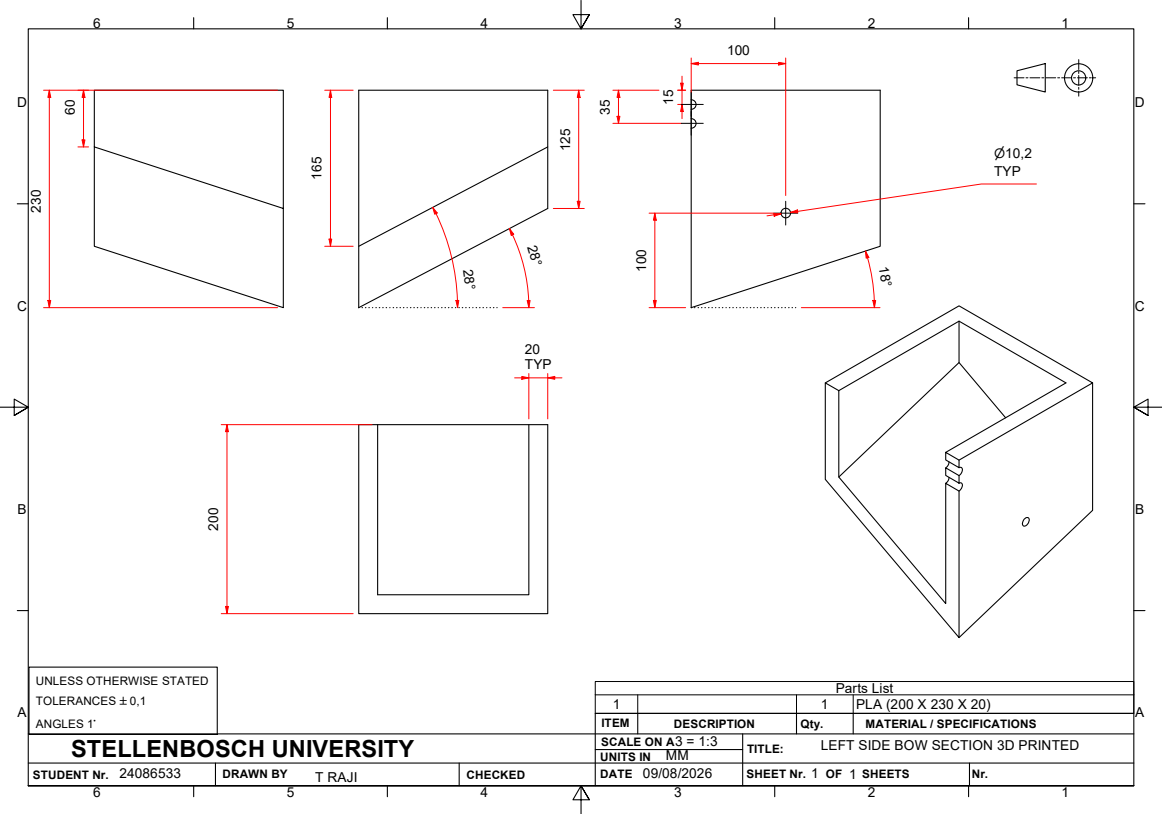
[picture p2: page 1]
Parts List; STUDENT Nr.; DRAWN BY; CHECKED; UNITS IN; SHEET Nr.; SHEETS; T RAJI

UNLESS OTHERWISE STATED
TOLERANCES `0,1
ANGLES 1~

1 | | 1 | PLA (200 X 230 X 20)
ITEM | DESCRIPTION | Qty. | MATERIAL / SPECIFICATIONS

STELLENBOSCH UNIVERSITY | 3 = 1:3 SCALE ON A | LEFT SIDE BOW SECTION 3D PRINTED TITLE:
