Taiye24/Final-Year-Mechatronics-Project-478/CAD FILES/PLANING HULL ASSEMBLY.pdf

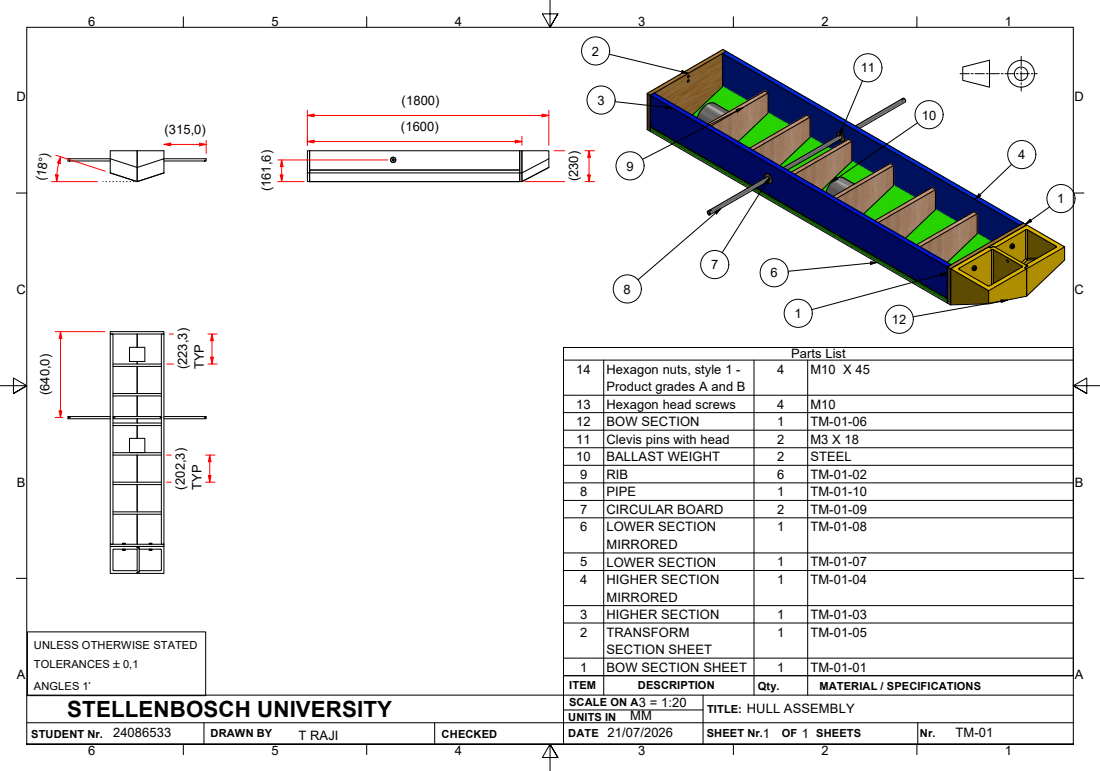
[picture p3: page 1]
Parts List; STUDENT Nr.; DRAWN BY; CHECKED; UNITS IN; SHEET Nr.; SHEETS; T RAJI

14 | Hexagon nuts, style 1 -Product grades A and B | 4 | M10 X 45

13 | Hexagon head screws | 4 | M10
12 | BOW SECTION | 1 | TM-01-06
11 | Clevis pins with head | 2 | M3 X 18
10 | BALLAST WEIGHT | 2 | STEEL
9 | RIB | 6 | TM-01-02
8 | PIPE | 1 | TM-01-10
7 | CIRCULAR BOARD | 2 | TM-01-09
6 | LOWER SECTION MIRRORED | 1 | TM-01-08

5 | LOWER SECTION | 1 | TM-01-07
4 | HIGHER SECTION MIRRORED | 1 | TM-01-04

3 | HIGHER SECTION | 1 | TM-01-03
2 | TRANSFORM SECTION SHEET | 1 | TM-01-05

UNLESS OTHERWISE STATED
TOLERANCES `0,1
ANGLES 1~

1 | BOW SECTION SHEET | 1 | TM-01-01
ITEM | DESCRIPTION | Qty. | MATERIAL / SPECIFICATIONS

STELLENBOSCH UNIVERSITY | 3 = 1:20 SCALE ON A | HULL ASSEMBLY TITLE:
