Taiye24/Final-Year-Mechatronics-Project-478/SAMPLE CALCULATIONS/Sample_Calculations_Chapter4.pdf

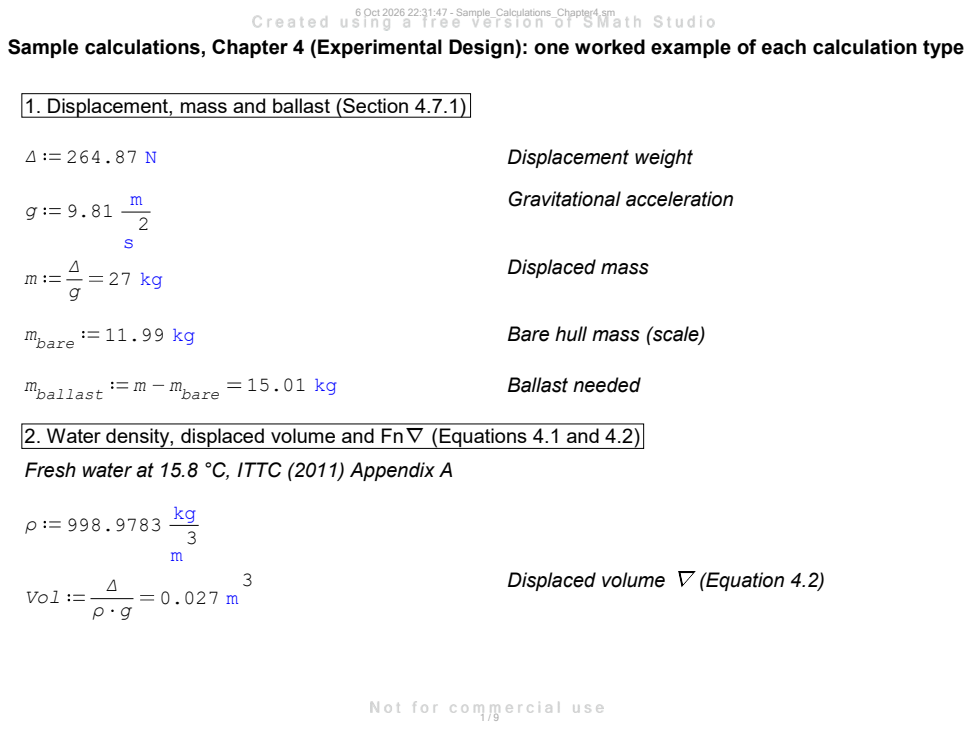
[picture p4: page 1]
Displacement weight; Gravitational acceleration; Displaced mass; 11.99 kg bare; Bare hull mass (scale); 15.01 kg bare m; m ballast; Ballast needed; Vol; Displaced volume; (Equation 4.2); 6 Oct 2026 22:31:47 - Sample_Calculations_Chapter4.sm

Sample calculations, Chapter 4 (Experimental Design): one worked example of each calculation type

1. Displacement, mass and ballast (Section 4.7.1)

2. Water density, displaced volume and Fn∇ (Equations 4.1 and 4.2)
Fresh water at 15.8 °C, ITTC (2011) Appendix A

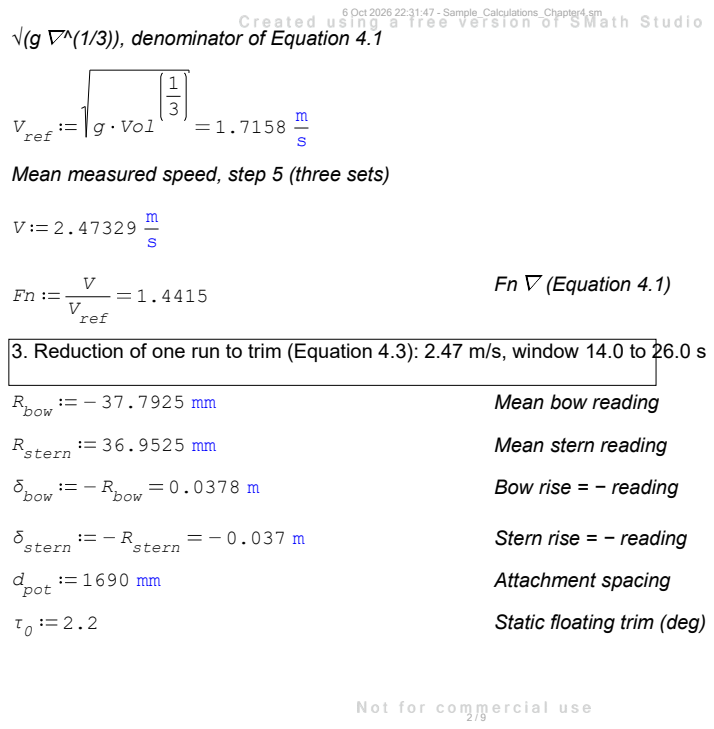
[picture p5: page 2]
V g Vol ref; Vref; (Equation 4.1); 37.7925 mm bow; Mean bow reading; 36.9525 mm stern; Mean stern reading; 0.0378 m bow δbow; Bow rise = − reading; 0.037 m stern δstern; Stern rise = − reading; 1690 mm pot; Attachment spacing; Static floating trim (deg)

√(g ^(1/3)), denominator of Equation 4.1

Mean measured speed, step 5 (three sets)

3. Reduction of one run to trim (Equation 4.3): 2.47 m/s, window 14.0 to 26.0 s

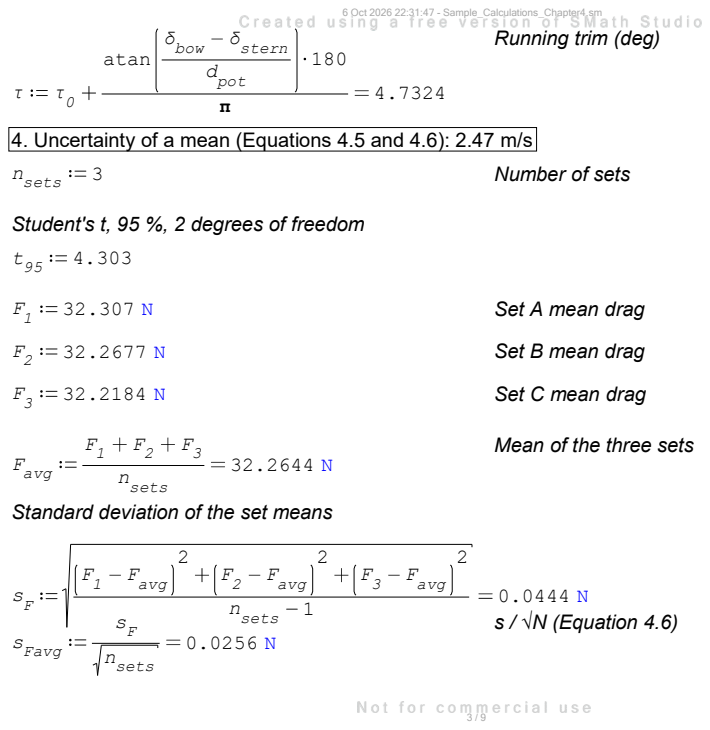
[picture p6: page 3]
atan; 180 dpot; δstern δbow; 3 sets; Number of sets; Set A mean drag; Set B mean drag; Set C mean drag; nsets; 1 sets; F avg; sFavg; s / √N (Equation 4.6)

Running trim (deg)

4. Uncertainty of a mean (Equations 4.5 and 4.6): 2.47 m/s

Student's t, 95 %, 2 degrees of freedom

avg
Standard deviation of the set means

Mean of the three sets

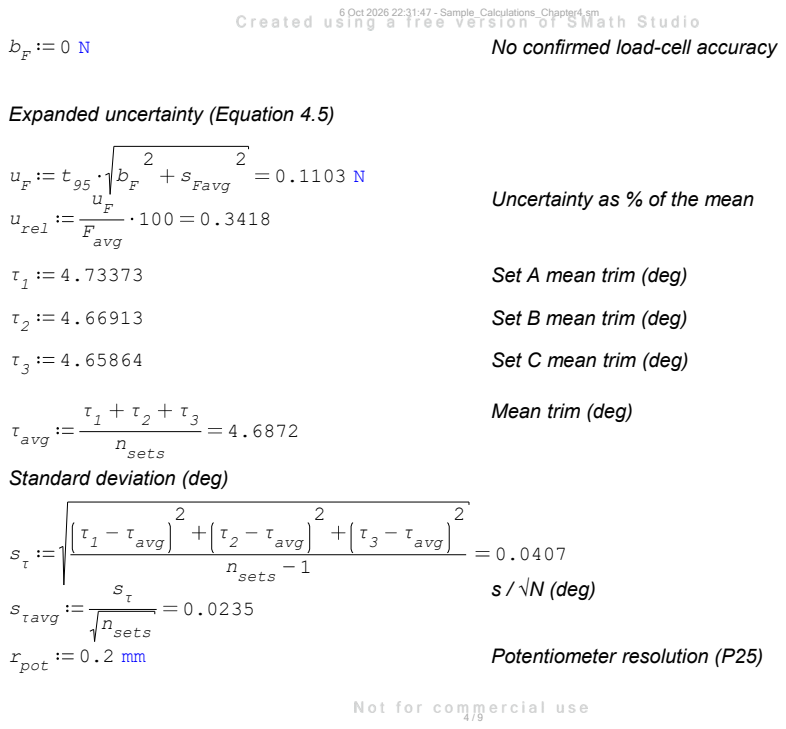
[picture p7: page 4]
No confirmed load-cell accuracy; sFavg; F avg; urel; Set A mean trim (deg); Set B mean trim (deg); Set C mean trim (deg); nsets; τ avg; Standard deviation (deg); 1 sets; s τavg; s / √N (deg); 0.2 mm pot; Potentiometer resolution (P25)

Expanded uncertainty (Equation 4.5)

Uncertainty as % of the mean

Mean trim (deg)

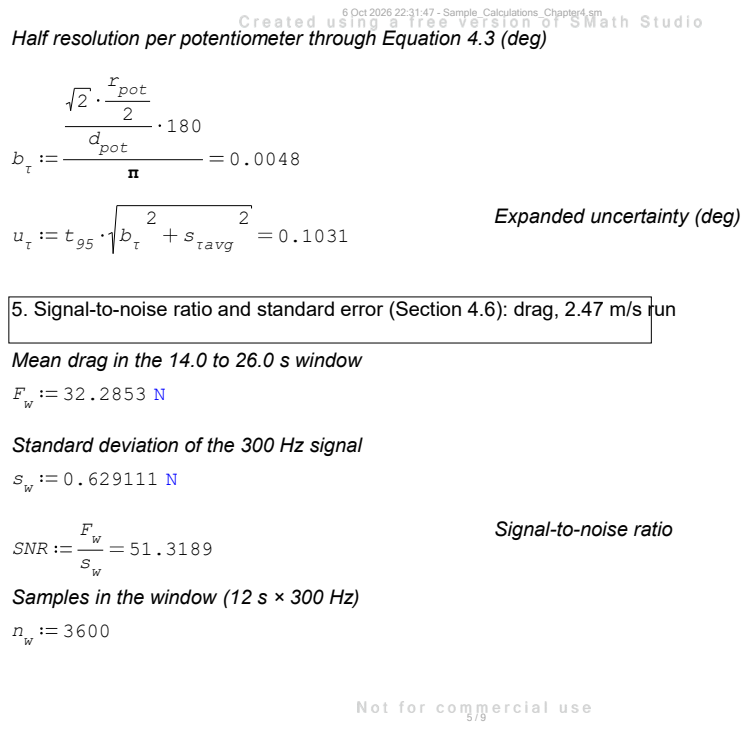
[picture p8: page 5]
180 dpot; rpot 2; s τavg; Mean drag in the 14.0 to 26.0 s window F 32.2853 N w; Standard deviation of the 300 Hz signal; F w SNR

Half resolution per potentiometer through Equation 4.3 (deg)

Expanded uncertainty (deg)

5. Signal-to-noise ratio and standard error (Section 4.6): drag, 2.47 m/s run

Signal-to-noise ratio

Samples in the window (12 s × 300 Hz)

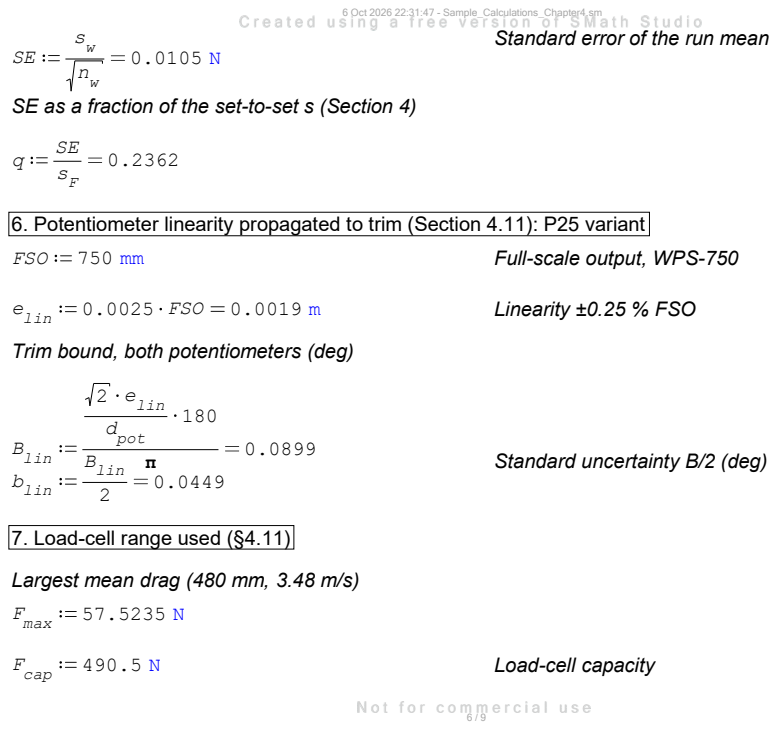
[picture p9: page 6]
FSO; Full-scale output, WPS-750; 0.0025 FSO 0.0019 m lin; Linearity ±0.25 % FSO; 180 dpot; elin 2; Blin; Blin blin; Largest mean drag (480 mm, 3.48 m/s) F 57.5235 N max; cap; Load-cell capacity

Standard error of the run mean

SE as a fraction of the set-to-set s (Section 4)

6. Potentiometer linearity propagated to trim (Section 4.11): P25 variant

Trim bound, both potentiometers (deg)

Standard uncertainty B/2 (deg)

7. Load-cell range used (§4.11)

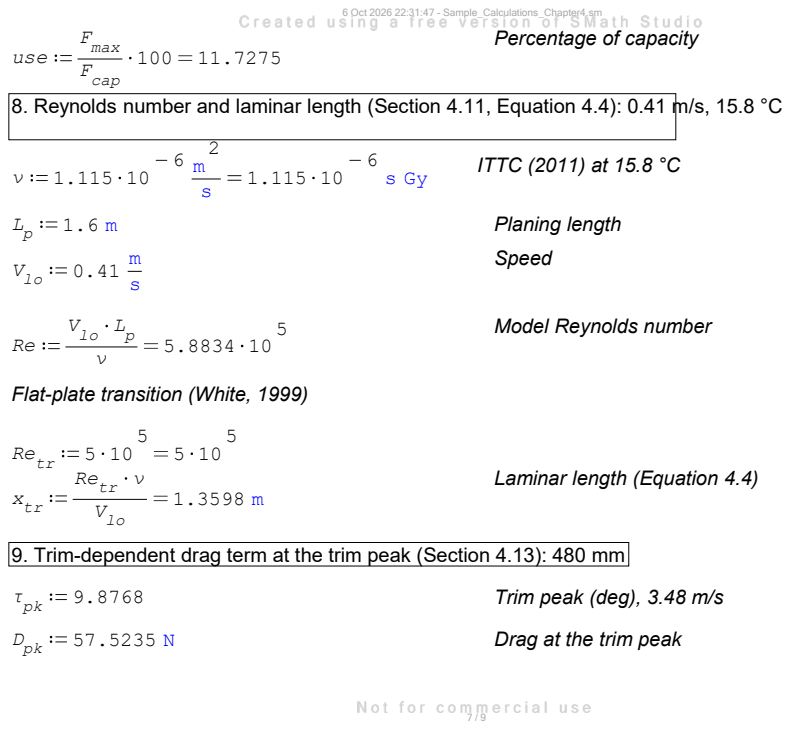
[picture p10: page 7]
F cap; F max; use; ITTC (2011) at 15.8 °C; Planing length; Speed; Vlo Re; Vlo; xtr; Trim peak (deg), 3.48 m/s; Drag at the trim peak

Percentage of capacity

8. Reynolds number and laminar length (Section 4.11, Equation 4.4): 0.41 m/s, 15.8 °C

Model Reynolds number

Flat-plate transition (White, 1999)

Laminar length (Equation 4.4)

9. Trim-dependent drag term at the trim peak (Section 4.13): 480 mm

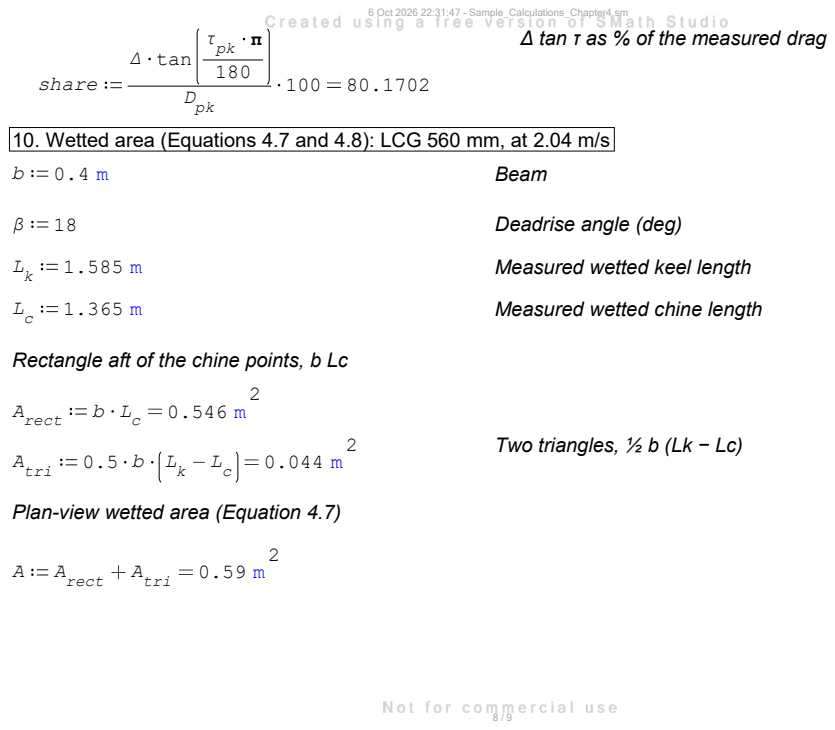
[picture p11: page 8]
Dpk; tan; share; Beam; Deadrise angle (deg); Measured wetted keel length; Measured wetted chine length; A b rect; A 0.5 b tri; A 0.59 m tri Arect A

Δ tan τ as % of the measured drag

10. Wetted area (Equations 4.7 and 4.8): LCG 560 mm, at 2.04 m/s

Rectangle aft of the chine points, b Lc

Two triangles, ½ b (Lk − Lc)

Plan-view wetted area (Equation 4.7)

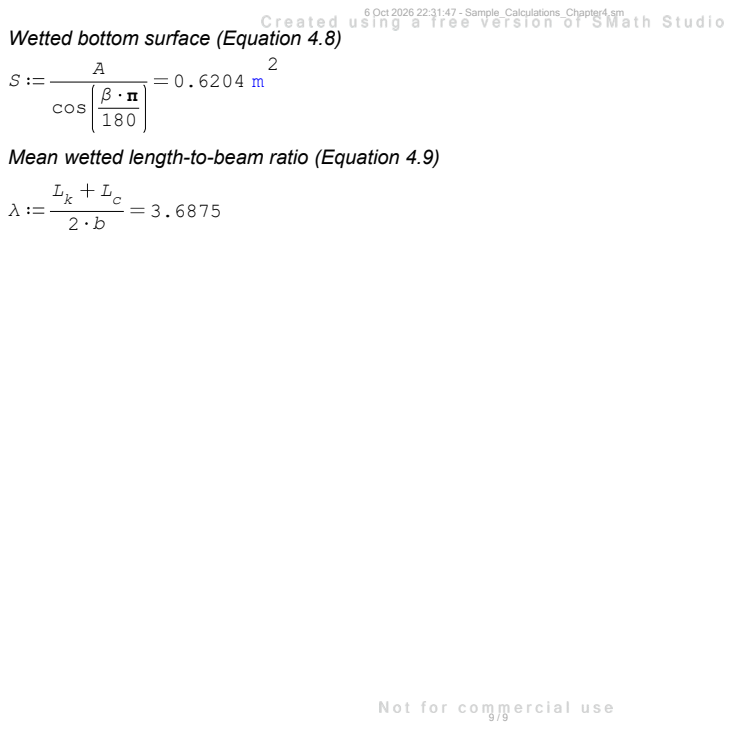
[picture p12: page 9]
Wetted bottom surface (Equation 4.8) 2; cos

Mean wetted length-to-beam ratio (Equation 4.9)
