Taiye24/Final-Year-Mechatronics-Project-478/SAMPLE CALCULATIONS/Sample_Calculations_Chapter5.pdf

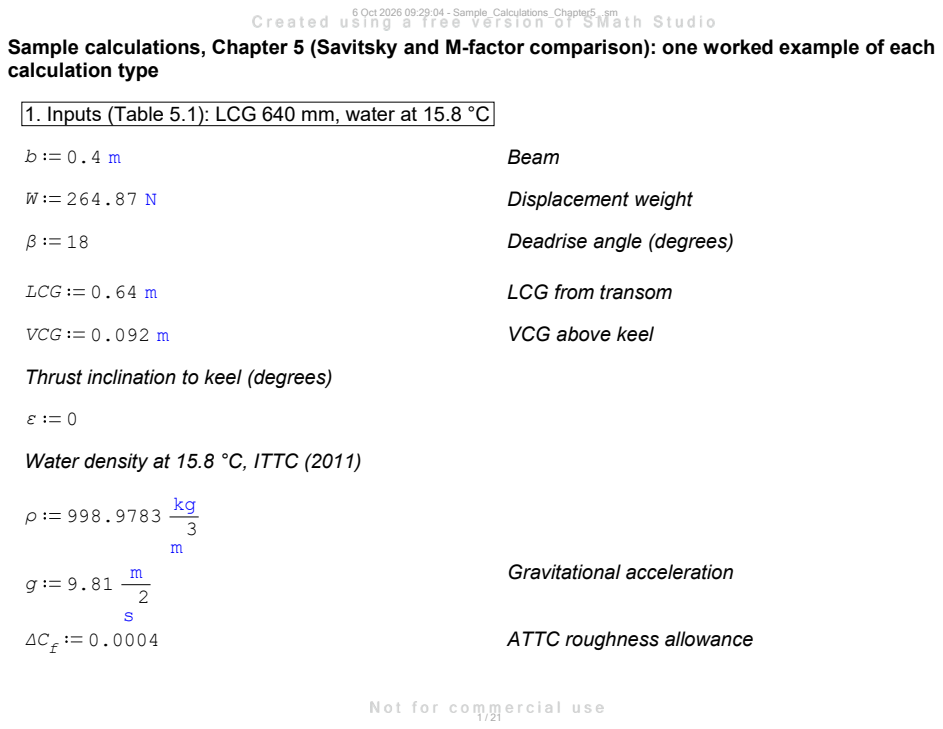
[picture p13: page 1]
Beam; Displacement weight; Deadrise angle (degrees); LCG; LCG from transom; VCG; VCG above keel; Gravitational acceleration; ATTC roughness allowance; 6 Oct 2026 09:29:04 - Sample_Calculations_Chapter5_.sm

Sample calculations, Chapter 5 (Savitsky and M-factor comparison): one worked example of each
calculation type

1. Inputs (Table 5.1): LCG 640 mm, water at 15.8 °C

Thrust inclination to keel (degrees)

Water density at 15.8 °C, ITTC (2011)

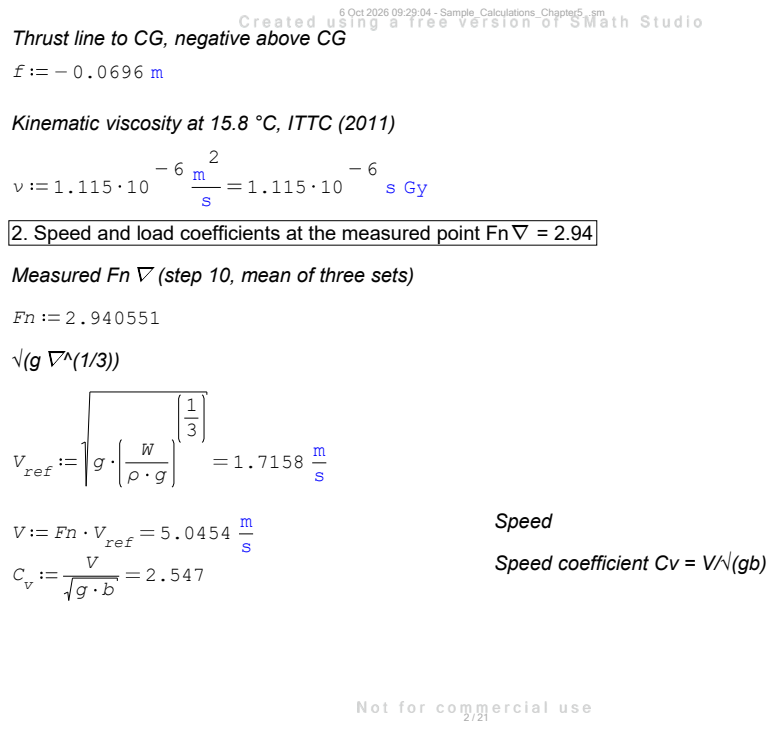
[picture p14: page 2]
Measured Fn; (step 10, mean of three sets); V g ref; 5.0454 ref V; Speed

Thrust line to CG, negative above CG

Kinematic viscosity at 15.8 °C, ITTC (2011)

2. Speed and load coefficients at the measured point Fn∇ = 2.94

Speed coefficient Cv = V/√(gb)

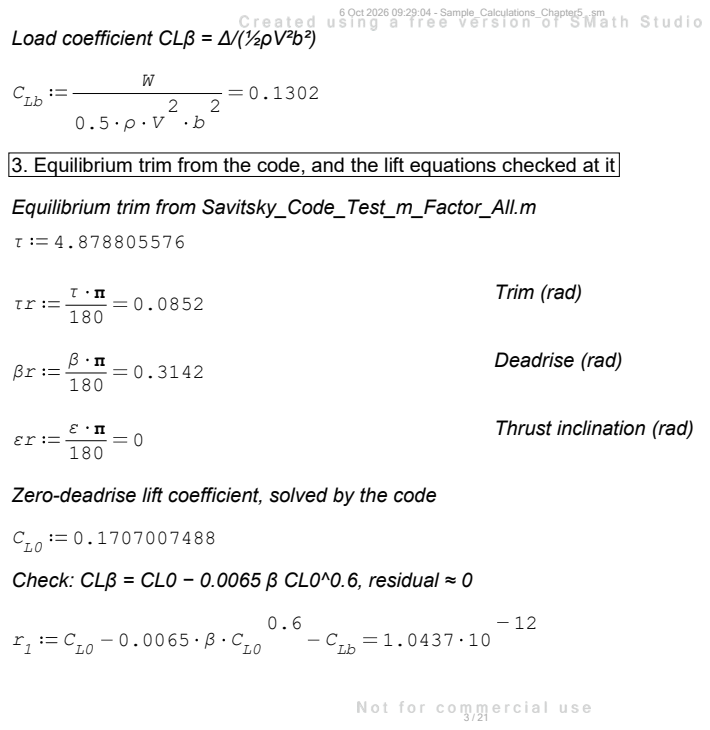
[picture p15: page 3]
Trim (rad); Deadrise (rad); Zero-deadrise lift coefficient, solved by the code

Load coefficient CLβ = Δ/(½ρV²b²)

CLb
3. Equilibrium trim from the code, and the lift equations checked at it

Equilibrium trim from Savitsky_Code_Test_m_Factor_All.m

Thrust inclination (rad)

Check: CLβ = CL0 − 0.0065 β CL0^0.6, residual ≈ 0

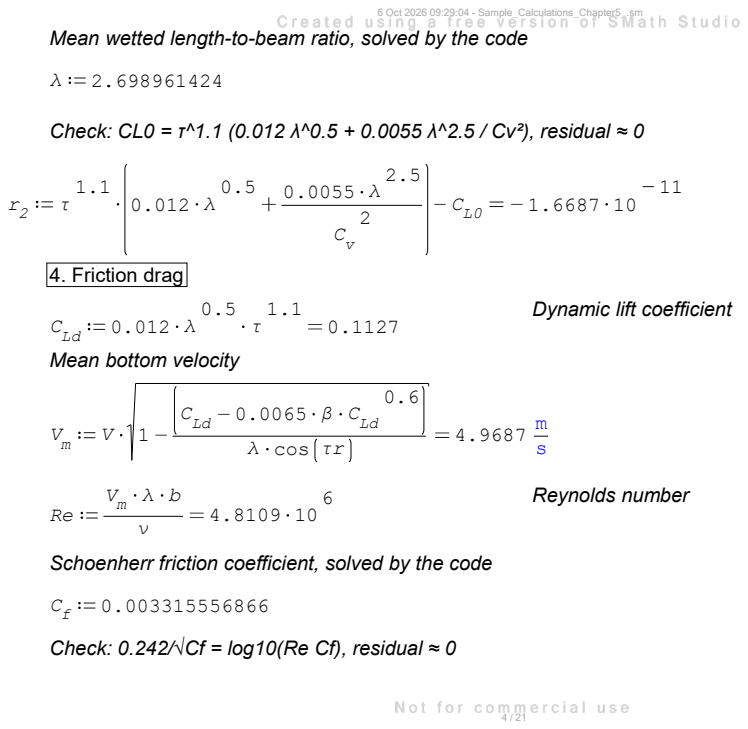
[picture p16: page 4]
4. Friction drag; λ cos τr; CLd C; Reynolds number

Mean wetted length-to-beam ratio, solved by the code

Check: CL0 = τ^1.1 (0.012 λ^0.5 + 0.0055 λ^2.5 / Cv²), residual ≈ 0

Dynamic lift coefficient

Mean bottom velocity

Schoenherr friction coefficient, solved by the code
Check: 0.242/√Cf = log10(Re Cf), residual ≈ 0

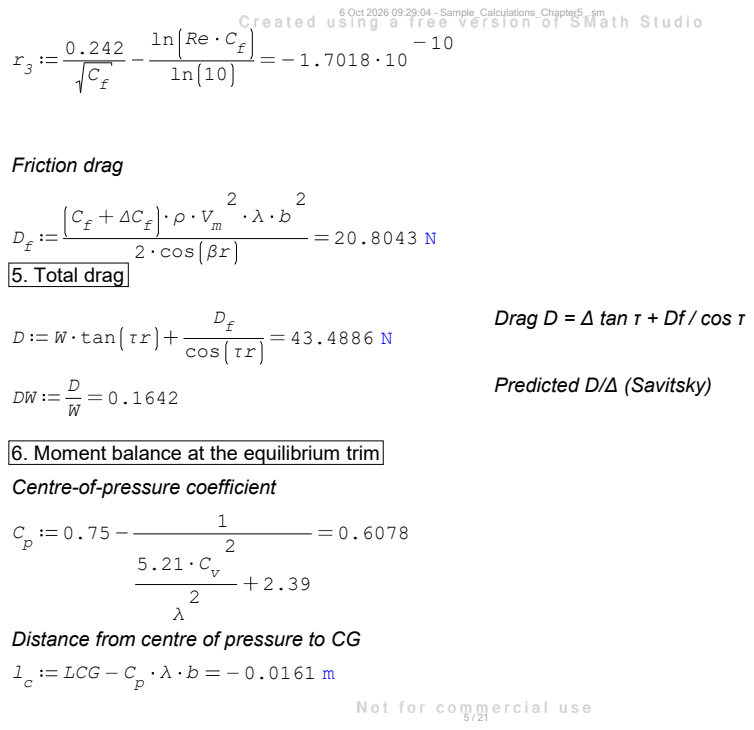
[picture p17: page 5]
Friction drag; 2 cos βr; 5. Total drag; cos τr; W tan τr; Predicted D/Δ (Savitsky); LCG

Drag D = Δ tan τ + Df / cos τ

6. Moment balance at the equilibrium trim
Centre-of-pressure coefficient

Distance from centre of pressure to CG

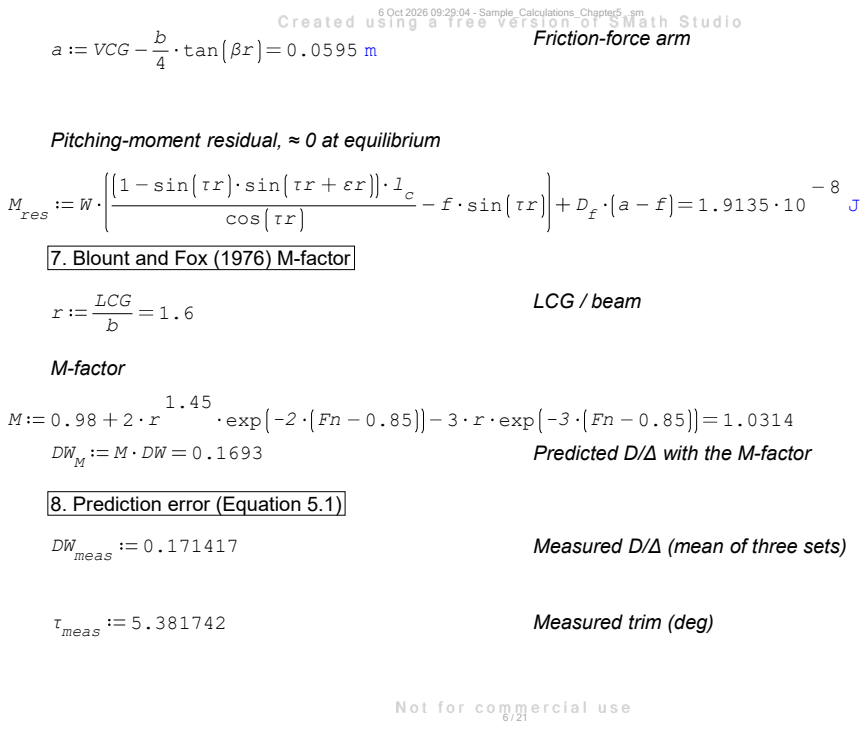
[picture p18: page 6]
tan βr; VCG; Friction-force arm; f sin τr; cos τr; M W res; 7. Blount and Fox (1976) M-factor; LCG; LCG / beam; M-factor; exp -2 Fn 0.85; 3 r exp -3 Fn 0.85; Predicted D/Δ with the M-factor; meas; Measured D/Δ (mean of three sets); Measured trim (deg)

Pitching-moment residual, ≈ 0 at equilibrium

1 sin τr sin τr εr

8. Prediction error (Equation 5.1)

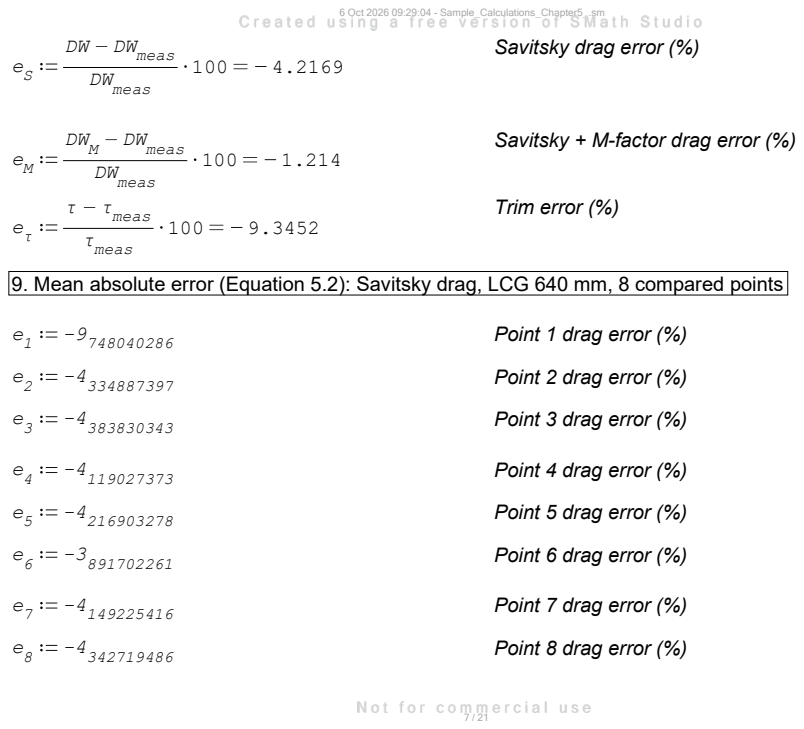
[picture p19: page 7]
DW meas; DWM; τ meas; Trim error (%); Point 1 drag error (%); Point 2 drag error (%); Point 3 drag error (%); Point 4 drag error (%); Point 5 drag error (%); Point 6 drag error (%); Point 7 drag error (%); Point 8 drag error (%)

Savitsky drag error (%)

Savitsky + M-factor drag error (%)

9. Mean absolute error (Equation 5.2): Savitsky drag, LCG 640 mm, 8 compared points

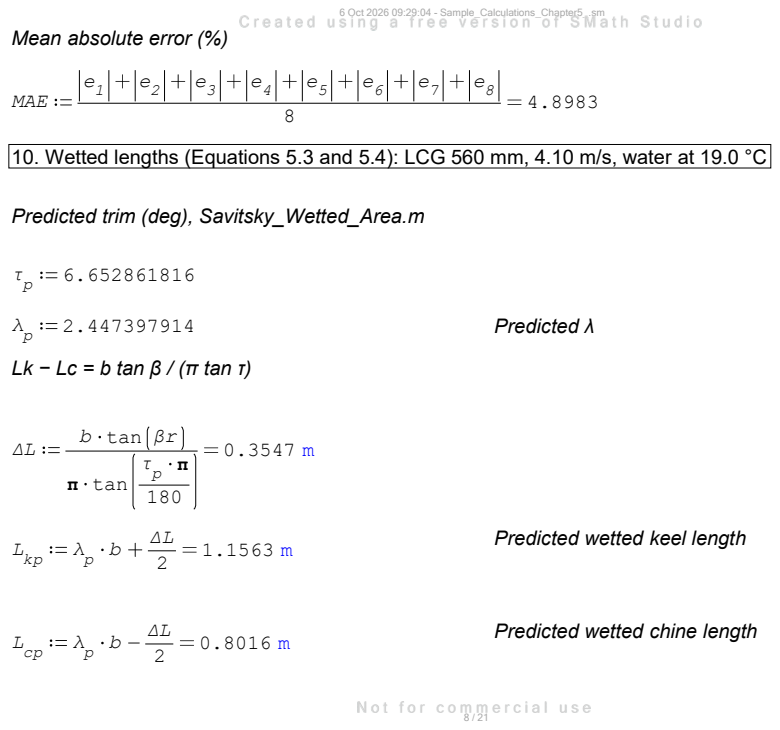
[picture p20: page 8]
MAE; Predicted λ; tan; b tan βr; Lkp

Mean absolute error (%)

10. Wetted lengths (Equations 5.3 and 5.4): LCG 560 mm, 4.10 m/s, water at 19.0 °C

Predicted trim (deg), Savitsky_Wetted_Area.m

Lk − Lc = b tan β / (π tan τ)

Predicted wetted keel length

Predicted wetted chine length

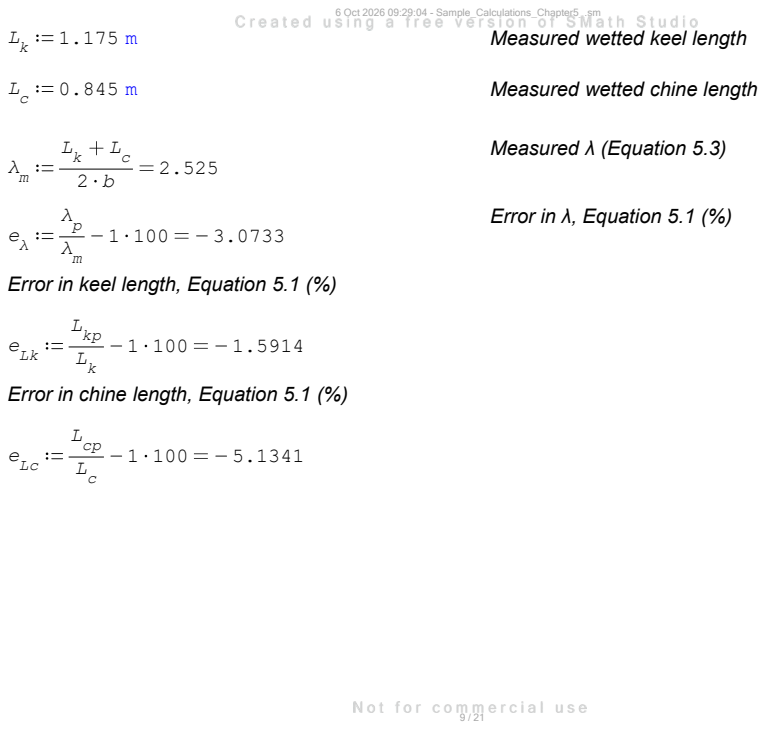
[picture p21: page 9]
Measured wetted keel length; Measured wetted chine length; Measured λ (Equation 5.3); Error in keel length, Equation 5.1 (%); Lkp eLk; Error in chine length, Equation 5.1 (%); L cp eLc

Error in λ, Equation 5.1 (%)

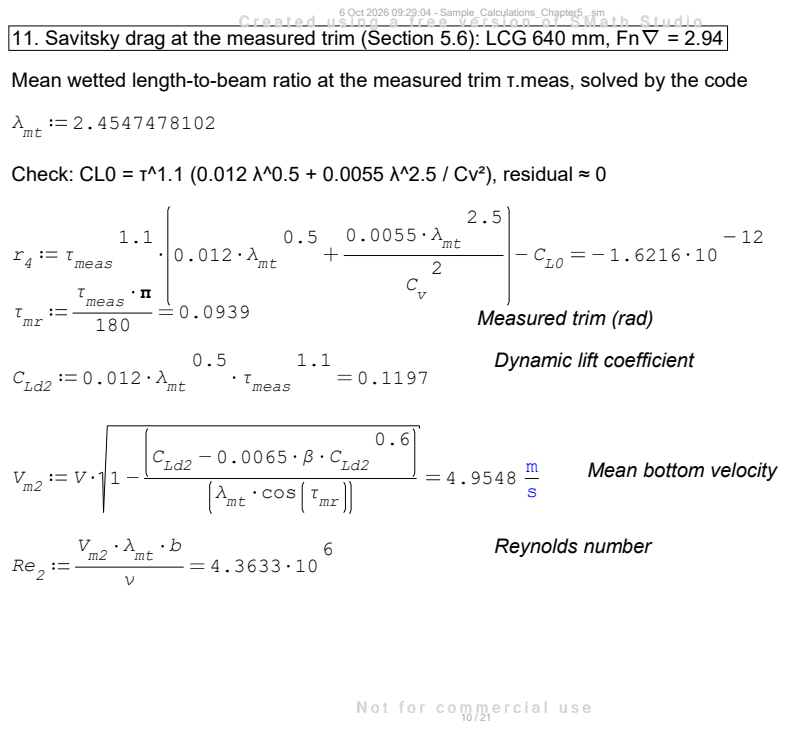
[picture p22: page 10]
λmt 0.5 0.0055; λmt 0.012; τ meas; meas; Measured trim (rad); λmt C; cos τ mr; λmt; CLd2 C; Mean bottom velocity; Reynolds number

11. Savitsky drag at the measured trim (Section 5.6): LCG 640 mm, Fn∇ = 2.94

Mean wetted length-to-beam ratio at the measured trim τ.meas, solved by the code

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

Dynamic lift coefficient

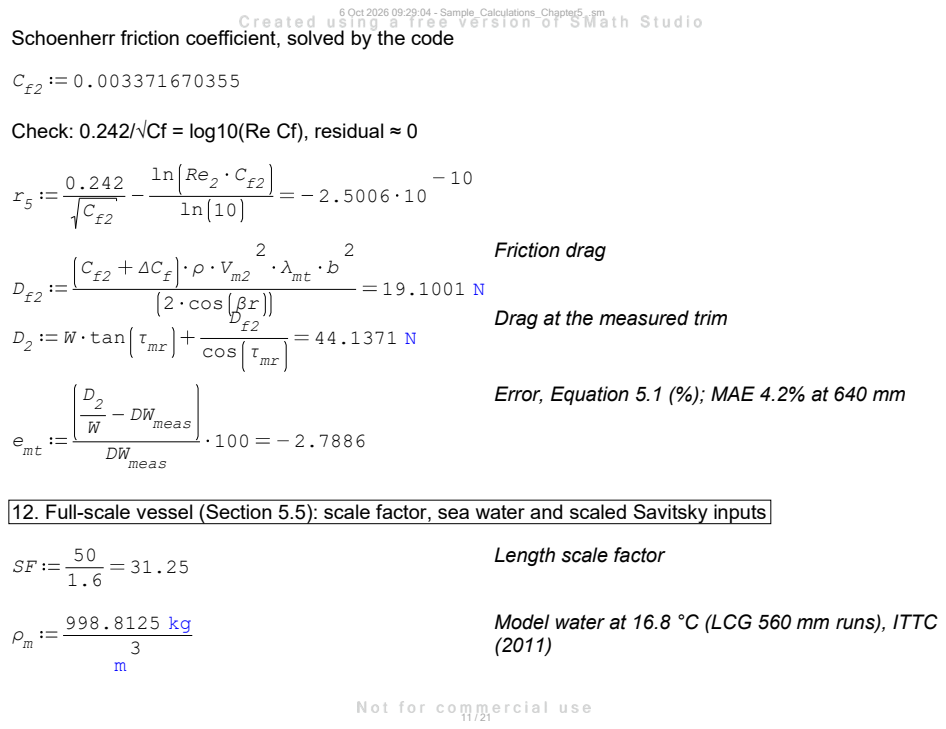
[picture p23: page 11]
2 cos βr; Friction drag; cos τ mr; tan τ mr; DW meas; DW W meas; emt; Length scale factor

Schoenherr friction coefficient, solved by the code

Check: 0.242/√Cf = log10(Re Cf), residual ≈ 0

Drag at the measured trim

Error, Equation 5.1 (%); MAE 4.2% at 640 mm

12. Full-scale vessel (Section 5.5): scale factor, sea water and scaled Savitsky inputs

Model water at 16.8 °C (LCG 560 mm runs), ITTC

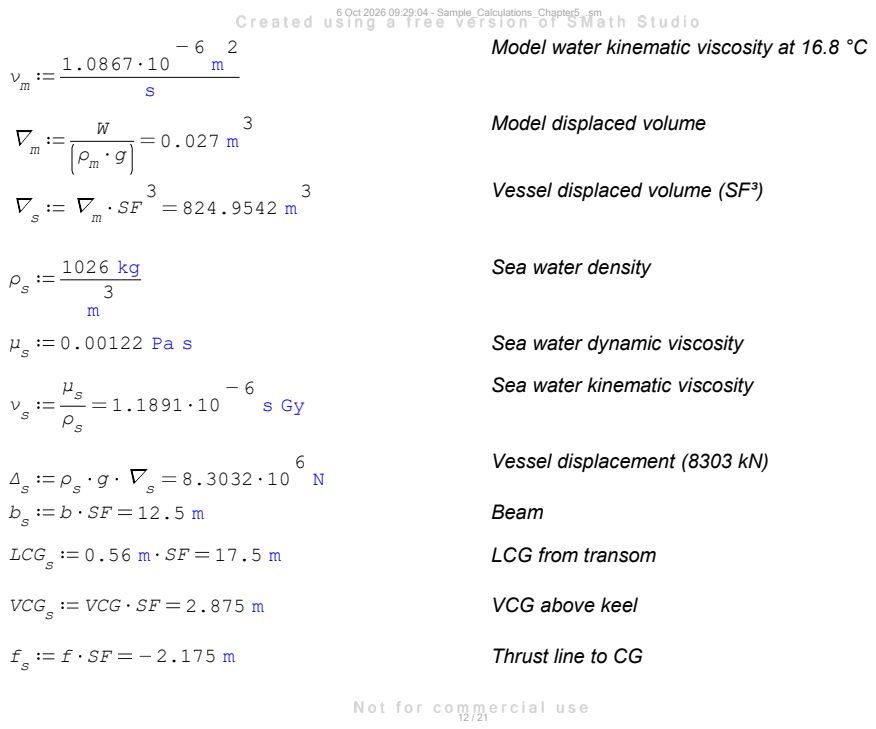
[picture p24: page 12]
Sea water dynamic viscosity; Beam; LCG; LCG from transom; VCG; VCG SF 2.875 m; VCG above keel; Thrust line to CG

Model water kinematic viscosity at 16.8 °C

Model displaced volume

Vessel displaced volume (SF³)

Sea water density

Sea water kinematic viscosity

Vessel displacement (8303 kN)

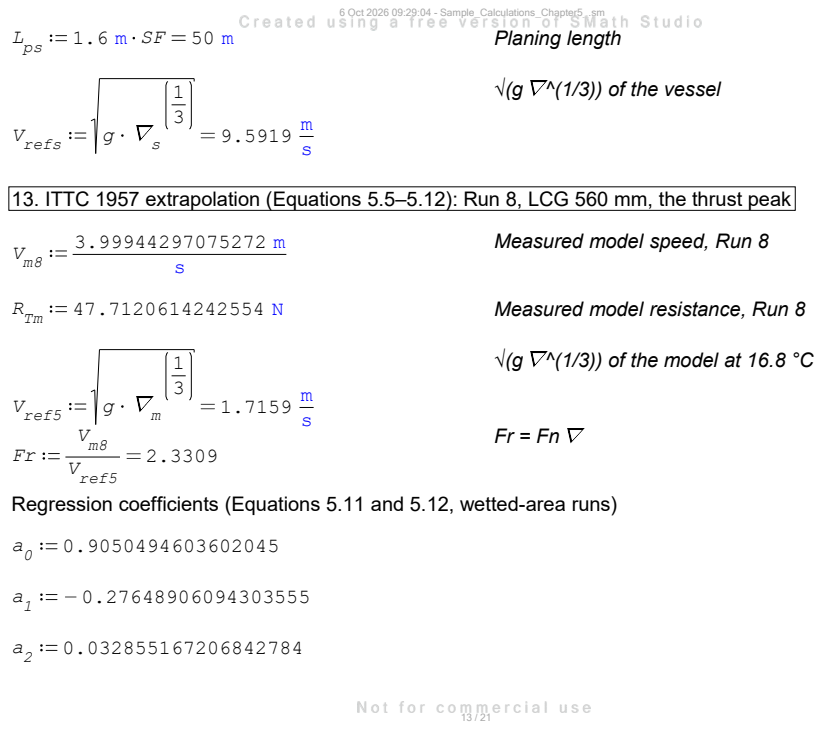
[picture p25: page 13]
Planing length; V g refs; Measured model resistance, Run 8; V g ref5

√(g ^(1/3)) of the vessel

13. ITTC 1957 extrapolation (Equations 5.5–5.12): Run 8, LCG 560 mm, the thrust peak

Measured model speed, Run 8

√(g ^(1/3)) of the model at 16.8 °C

Vref5
Regression coefficients (Equations 5.11 and 5.12, wetted-area runs)

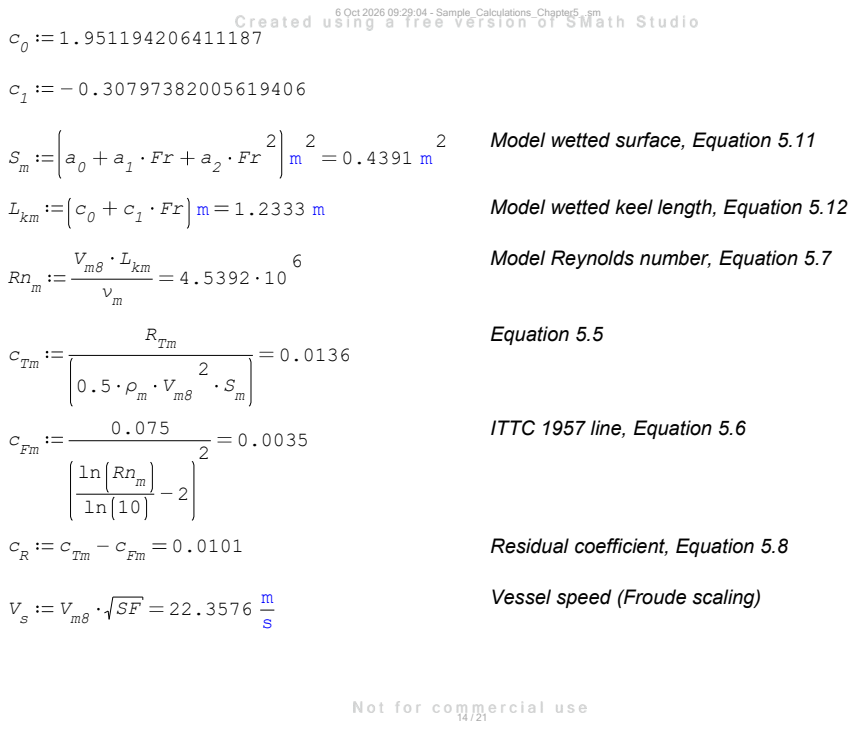
[picture p26: page 14]
Lkm; Model wetted keel length, Equation 5.12; Lkm Vm8 Rn; RTm; cTm; Equation 5.5; cFm; 0.0101 Fm cTm cR; Residual coefficient, Equation 5.8

Model wetted surface, Equation 5.11

Model Reynolds number, Equation 5.7

ITTC 1957 line, Equation 5.6

Vessel speed (Froude scaling)

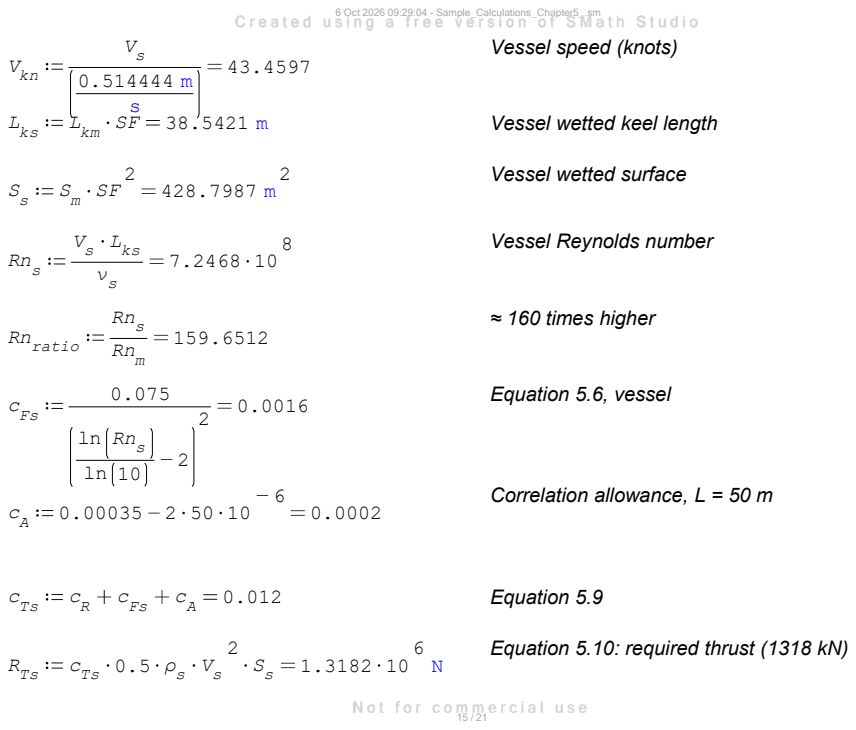
[picture p27: page 15]
V s Vkn; SF 38.5421 m km Lks; Vessel wetted keel length; Lks V s Rn s; Rn s Rnratio; ≈ 160 times higher; cFs; Equation 5.6, vessel; Correlation allowance, L = 50 m; cFs cR; cTs; Equation 5.9; 0.5 Ts RTs

Vessel speed (knots)

Vessel wetted surface

Vessel Reynolds number

Equation 5.10: required thrust (1318 kN)

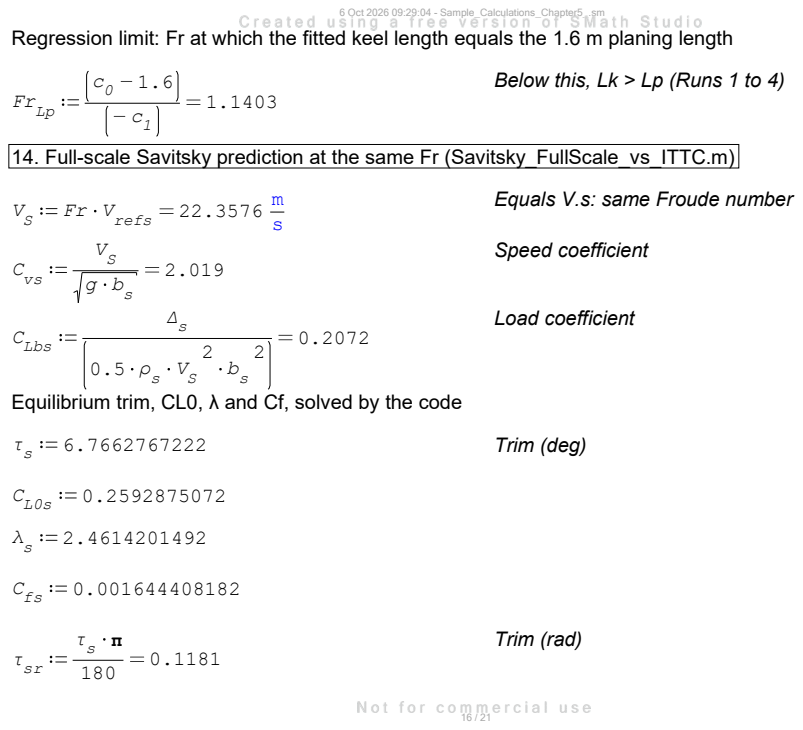
[picture p28: page 16]
FrLp; 22.3576 refs V; Speed coefficient; Δ s CLbs; Load coefficient; Trim (deg); Trim (rad)

Regression limit: Fr at which the fitted keel length equals the 1.6 m planing length

Below this, Lk > Lp (Runs 1 to 4)

14. Full-scale Savitsky prediction at the same Fr (Savitsky_FullScale_vs_ITTC.m)

Equals V.s: same Froude number

Equilibrium trim, CL0, λ and Cf, solved by the code

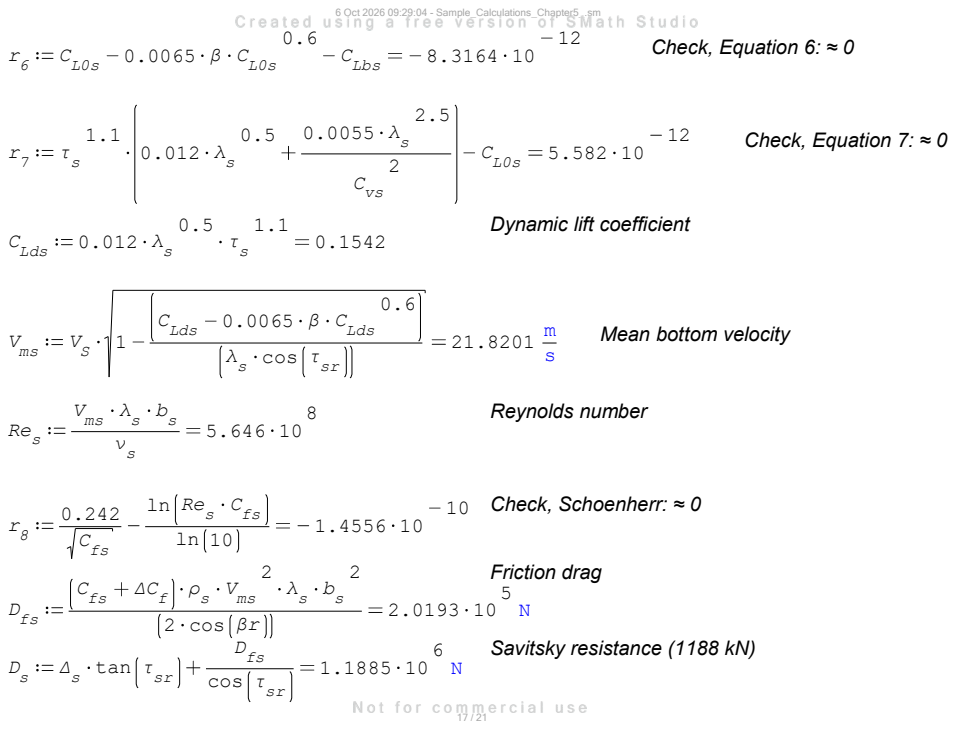
[picture p29: page 17]
C 8.3164 10 Lbs; Check, Equation 6: ≈ 0; Check, Equation 7: ≈ 0; C 0.012 Lds; cos τ sr; CLds C; 0.0065 β Lds; Mean bottom velocity; Reynolds number; Cfs Re; Cfs; Check, Schoenherr: ≈ 0; 2 cos βr; ΔCf; Dfs; Friction drag; Dfs tan τ; Savitsky resistance (1188 kN)

Dynamic lift coefficient

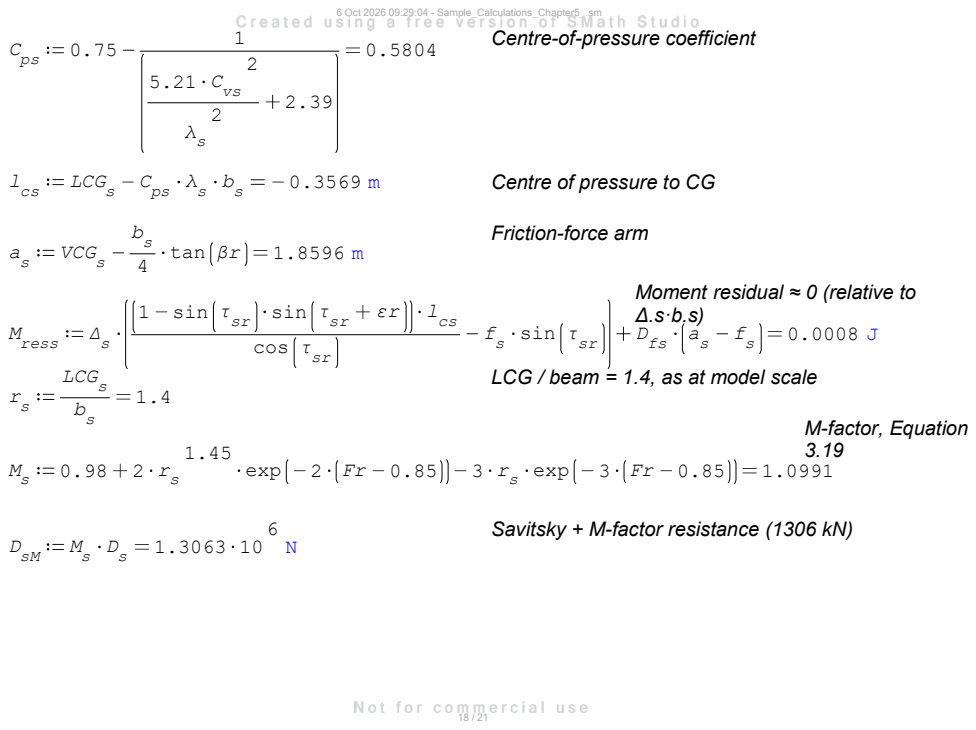
[picture p30: page 18]
LCG s; Centre of pressure to CG; tan βr; b s VCG s; Moment residual ≈ 0 (relative to Δ.s·b.s); Dfs sin τ sr; cos τ; sin τ; sin τ sr; M ress; M-factor, Equation 3.19; r exp; exp; DsM

Centre-of-pressure coefficient

Friction-force arm

LCG / beam = 1.4, as at model scale

Savitsky + M-factor resistance (1306 kN)

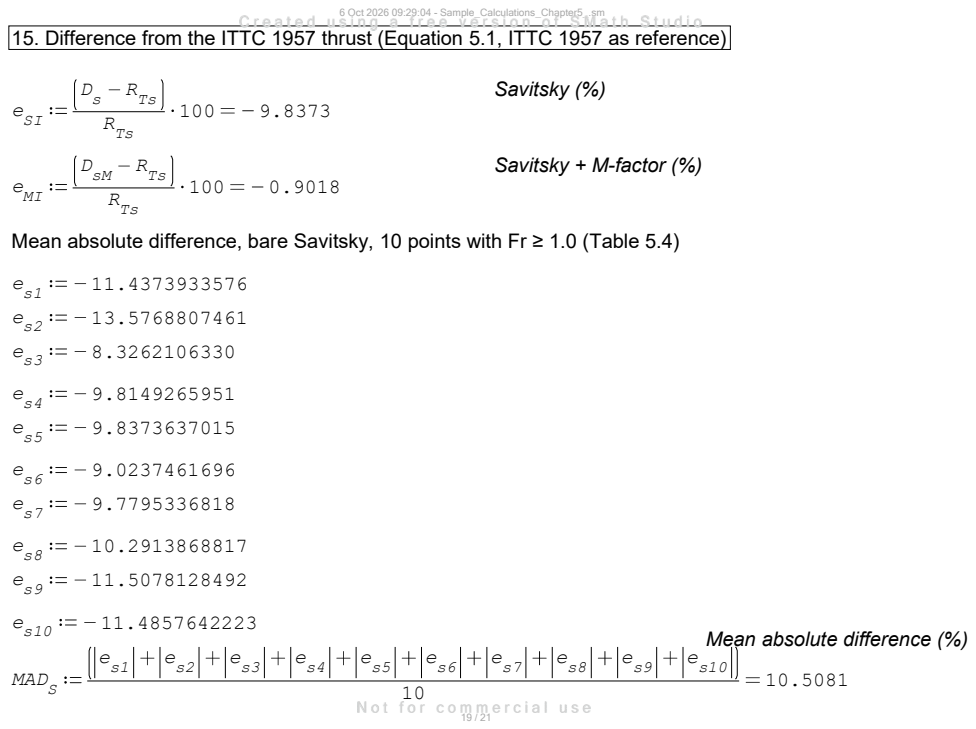
[picture p31: page 19]
RTs; RTs D s; eSI; Savitsky (%); RTs DsM; eMI; Savitsky + M-factor (%); Mean absolute difference (%); MADS

15. Difference from the ITTC 1957 thrust (Equation 5.1, ITTC 1957 as reference)

Mean absolute difference, bare Savitsky, 10 points with Fr ≥ 1.0 (Table 5.4)

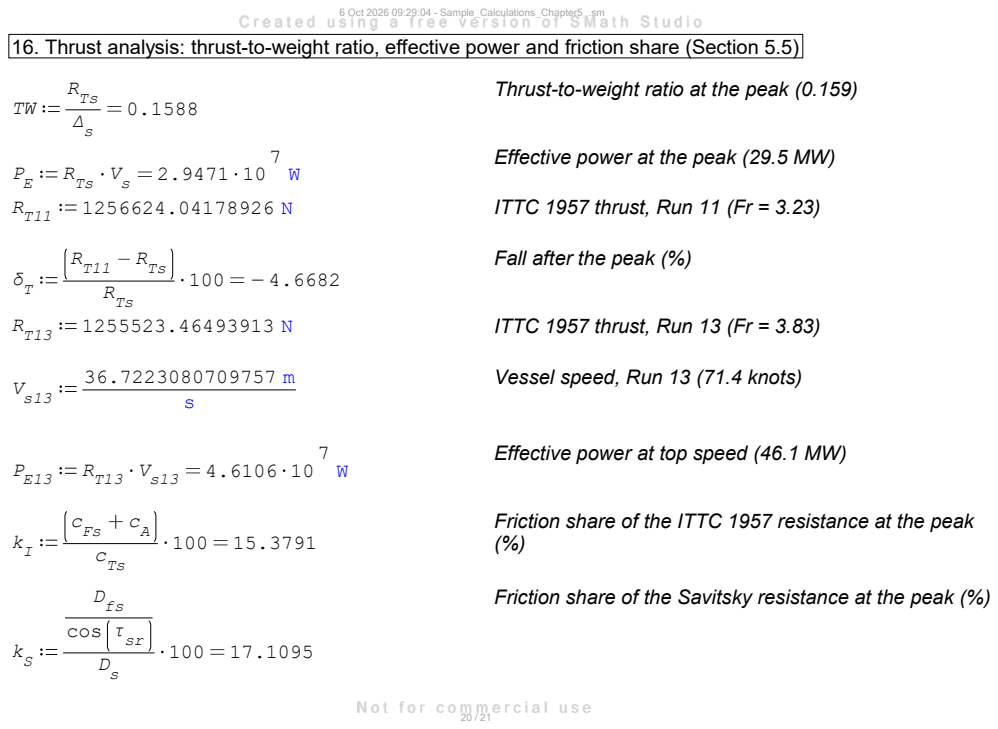
[picture p32: page 20]
RTs PE; ITTC 1957 thrust, Run 11 (Fr = 3.23); RTs; RTs RT11 δT; ITTC 1957 thrust, Run 13 (Fr = 3.83); cTs; cFs kI; cos τ sr; Dfs

16. Thrust analysis: thrust-to-weight ratio, effective power and friction share (Section 5.5)
RTs TW

Thrust-to-weight ratio at the peak (0.159)

Effective power at the peak (29.5 MW)

Fall after the peak (%)

Vessel speed, Run 13 (71.4 knots)

Effective power at top speed (46.1 MW)

Friction share of the ITTC 1957 resistance at the peak

Friction share of the Savitsky resistance at the peak (%)

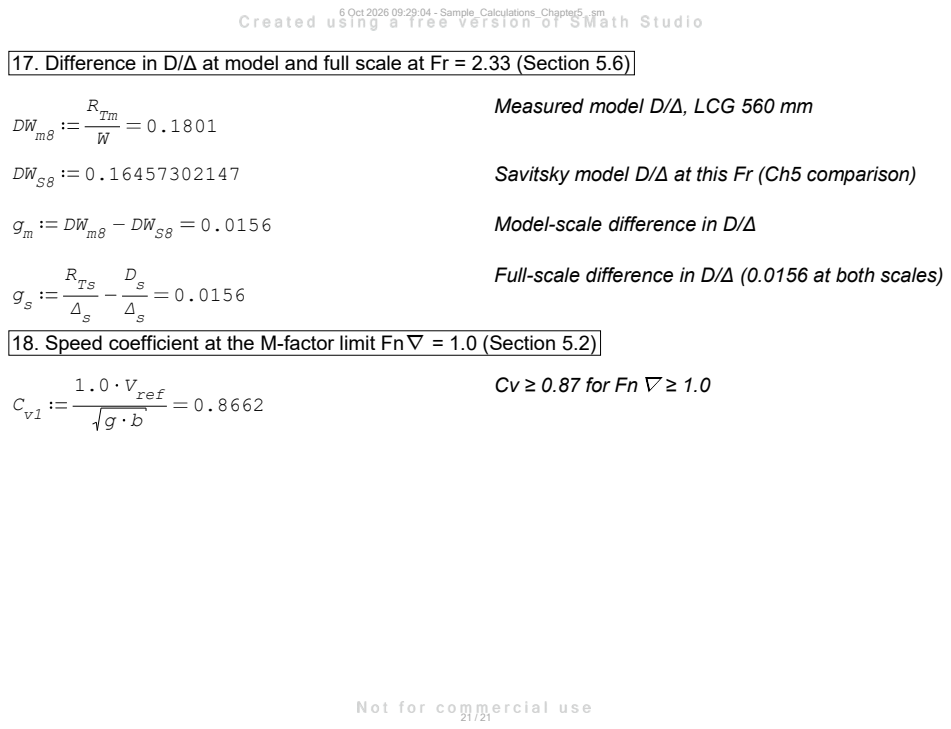
[picture p33: page 21]
RTm DWm8; Savitsky model D/Δ at this Fr (Ch5 comparison); 0.0156 S8 DWm8 gm; Model-scale difference in D/Δ; RTs; Cv ≥ 0.87 for Fn

17. Difference in D/Δ at model and full scale at Fr = 2.33 (Section 5.6)

Measured model D/Δ, LCG 560 mm

Full-scale difference in D/Δ (0.0156 at both scales)

18. Speed coefficient at the M-factor limit Fn∇ = 1.0 (Section 5.2)
Vref 1.0
