Taiye24/Final-Year-Mechatronics-Project-478/CAD FILES/Bow Plate.pdf

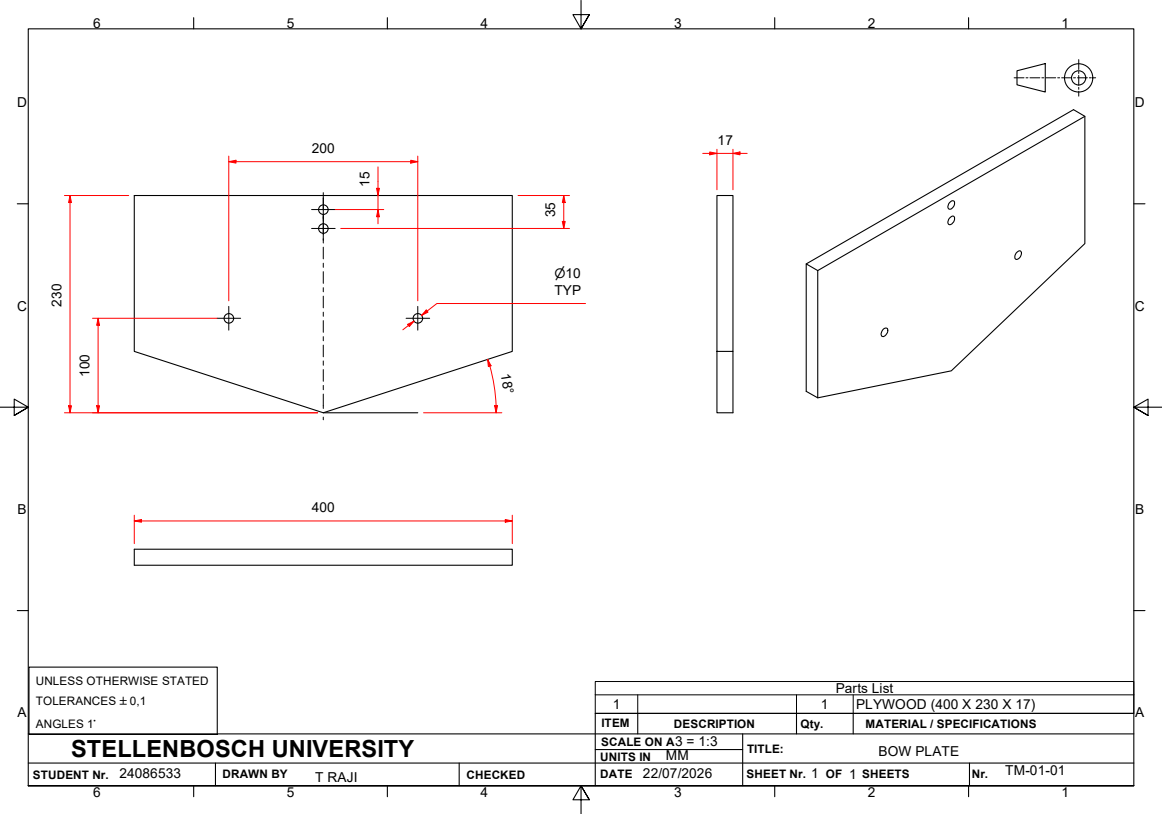
[picture p34: page 1]
Parts List; STUDENT Nr.; DRAWN BY; CHECKED; SCALE ON A UNITS IN; SHEET Nr.; SHEETS; T RAJI; BOW PLATE

UNLESS OTHERWISE STATED
TOLERANCES `0,1
ANGLES 1~
STELLENBOSCH UNIVERSITY

1 | | 1 | PLYWOOD (400 X 230 X 17)
ITEM | DESCRIPTION | Qty. | MATERIAL / SPECIFICATIONS
