Taiye24/Final-Year-Mechatronics-Project-478/CAD FILES/Circular Board 6mm.pdf

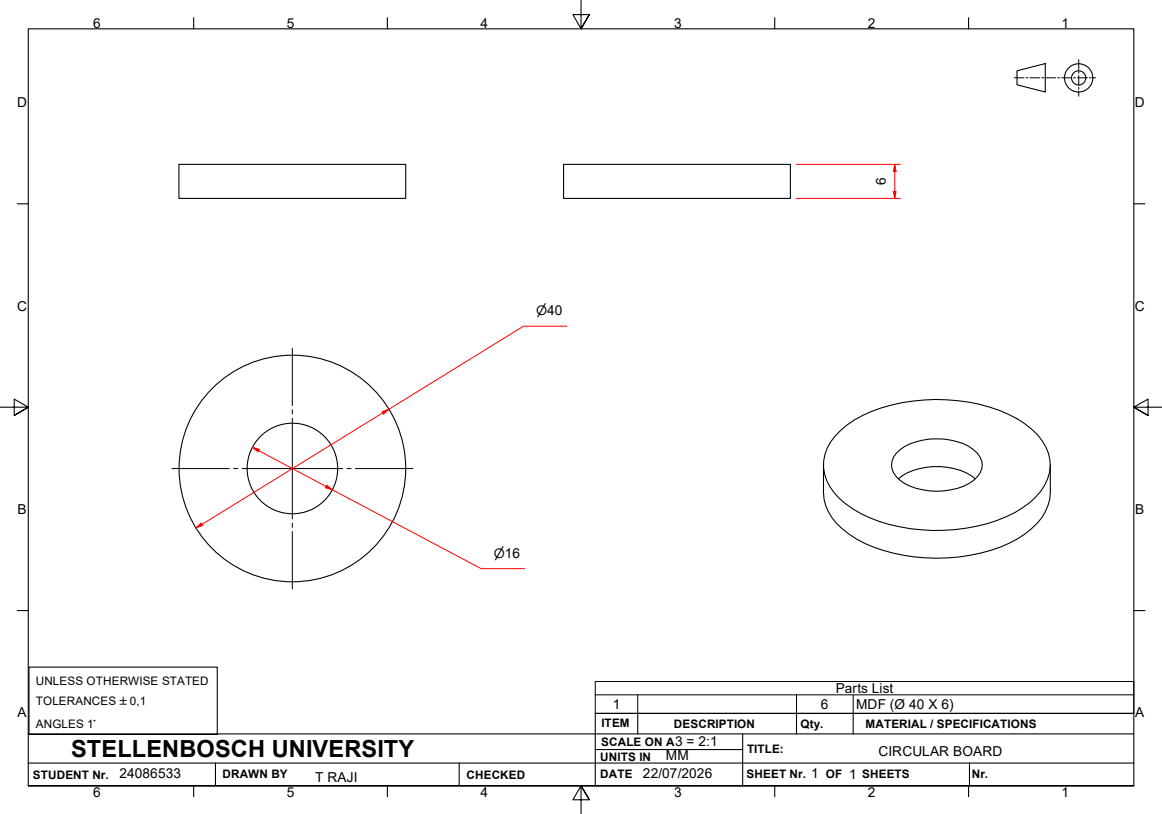
[picture p35: page 1]
Parts List; STUDENT Nr.; DRAWN BY; CHECKED; SCALE ON A UNITS IN; SHEET Nr.; SHEETS; T RAJI; CIRCULAR BOARD

UNLESS OTHERWISE STATED
TOLERANCES `0,1
ANGLES 1~
STELLENBOSCH UNIVERSITY

1 | | 6 | MDF (Ø 40 X 6)
ITEM | DESCRIPTION | Qty. | MATERIAL / SPECIFICATIONS
