Taiye24/Final-Year-Mechatronics-Project-478/CAD FILES/Circular Board.pdf

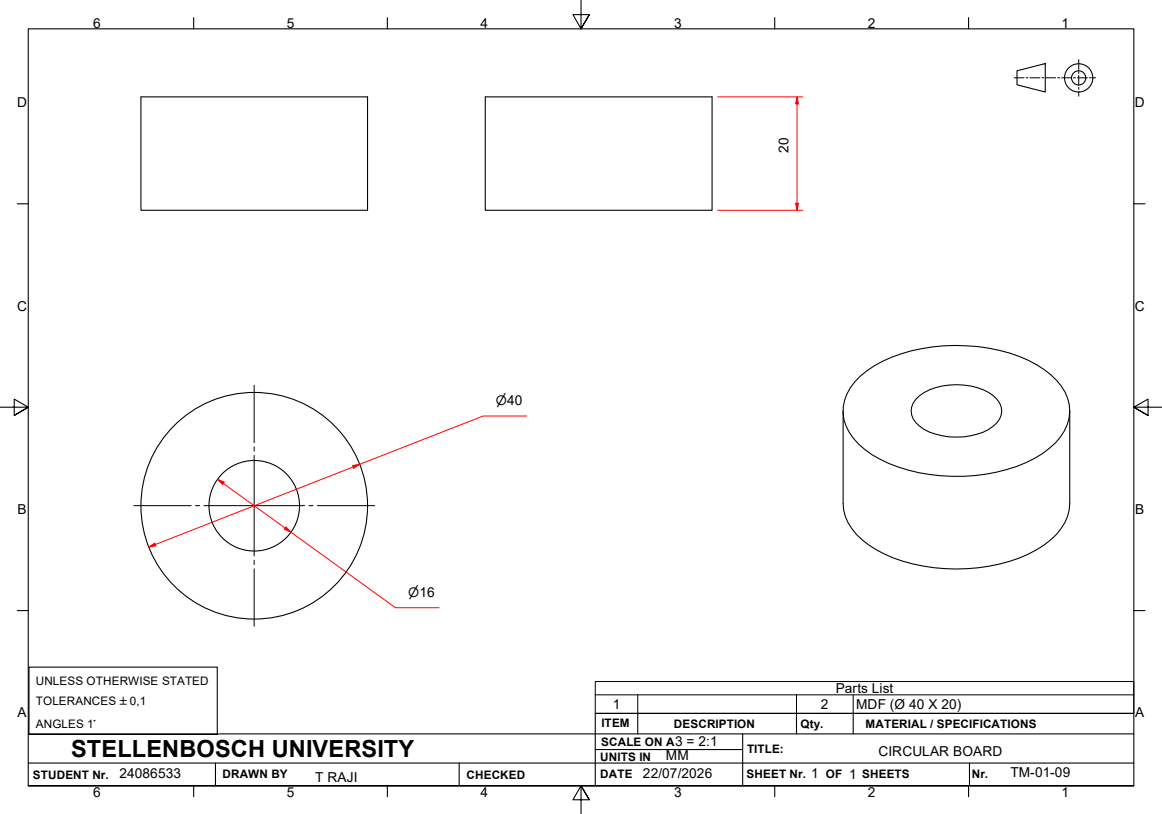
[picture p36: page 1]
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

UNLESS OTHERWISE STATED
TOLERANCES `0,1
ANGLES 1~
STELLENBOSCH UNIVERSITY

1 | | 2 | MDF (Ø 40 X 20)
ITEM | DESCRIPTION | Qty. | MATERIAL / SPECIFICATIONS
