Taiye24/Final-Year-Mechatronics-Project-478/CAD FILES/Higher_Section_Plate.pdf

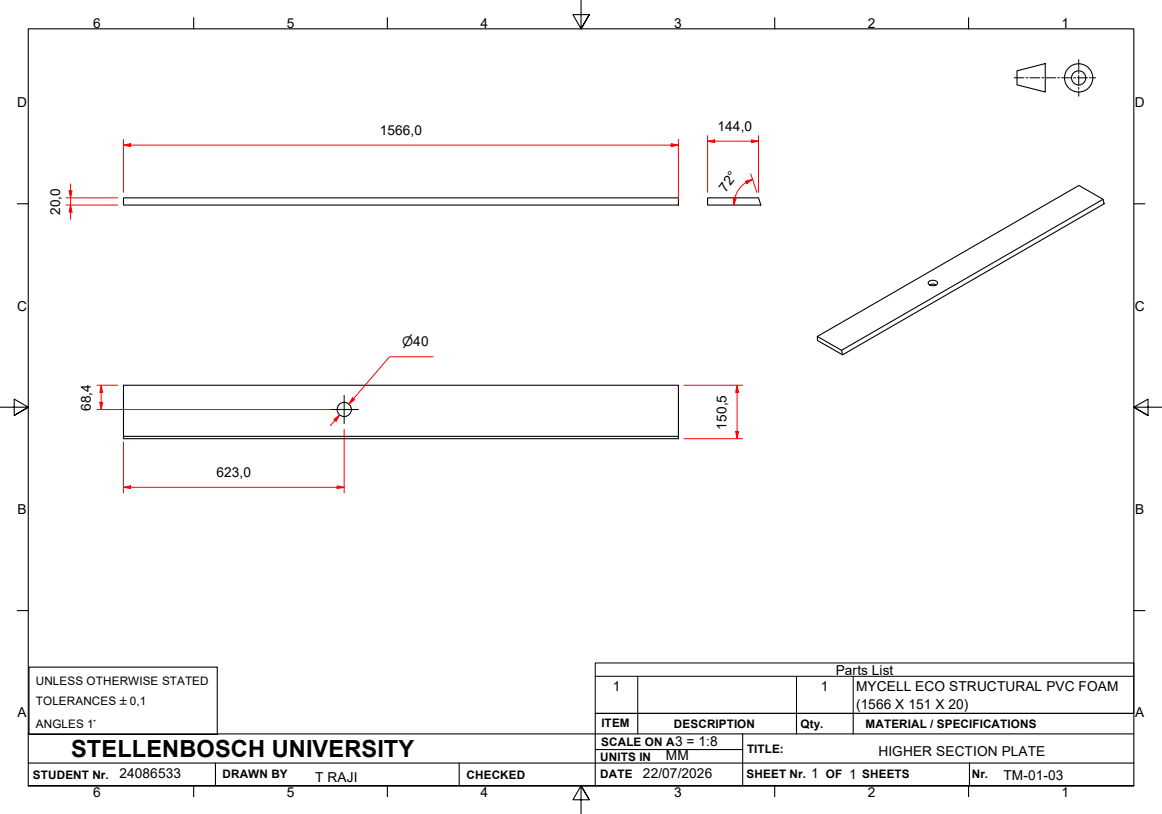
[picture p37: page 1]
Parts List; STUDENT Nr.; DRAWN BY; CHECKED; SCALE ON A UNITS IN; SHEET Nr.; SHEETS; T RAJI; HIGHER SECTION PLATE

UNLESS OTHERWISE STATED
TOLERANCES `0,1
ANGLES 1~
STELLENBOSCH UNIVERSITY

1 | | 1 | MYCELL ECO STRUCTURAL PVC FOAM (1566 X 151 X 20)

ITEM | DESCRIPTION | Qty. | MATERIAL / SPECIFICATIONS
