Taiye24/Final-Year-Mechatronics-Project-478/CAD FILES/Higher_Section_Plate_Mirrored.pdf

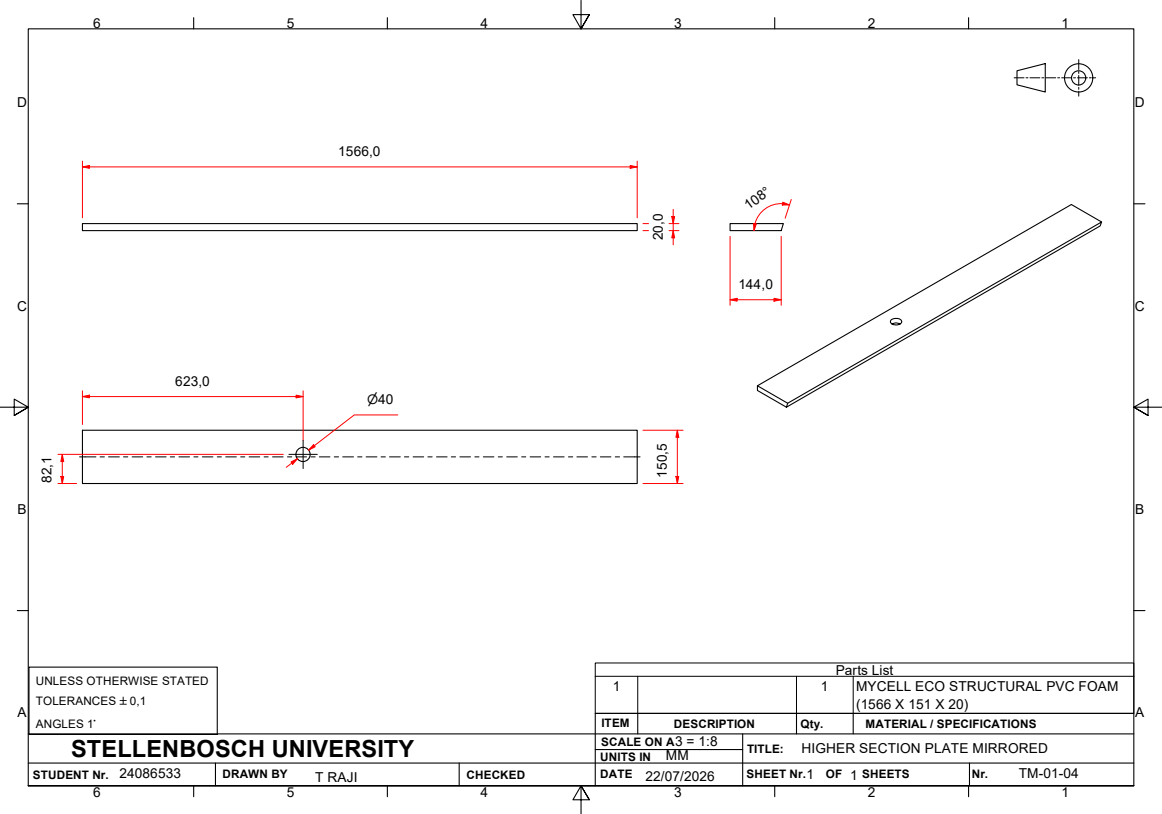
[picture p38: page 1]
Parts List; STUDENT Nr.; DRAWN BY; CHECKED; UNITS IN; SHEET Nr.; SHEETS; T RAJI

UNLESS OTHERWISE STATED
TOLERANCES `0,1
ANGLES 1~

1 | | 1 | MYCELL ECO STRUCTURAL PVC FOAM (1566 X 151 X 20)

ITEM | DESCRIPTION | Qty. | MATERIAL / SPECIFICATIONS

STELLENBOSCH UNIVERSITY | 3 = 1:8 SCALE ON A | TITLE: HIGHER SECTION PLATE MIRRORED
