Taiye24/Final-Year-Mechatronics-Project-478/CAD FILES/Lower_Section_Plate.pdf

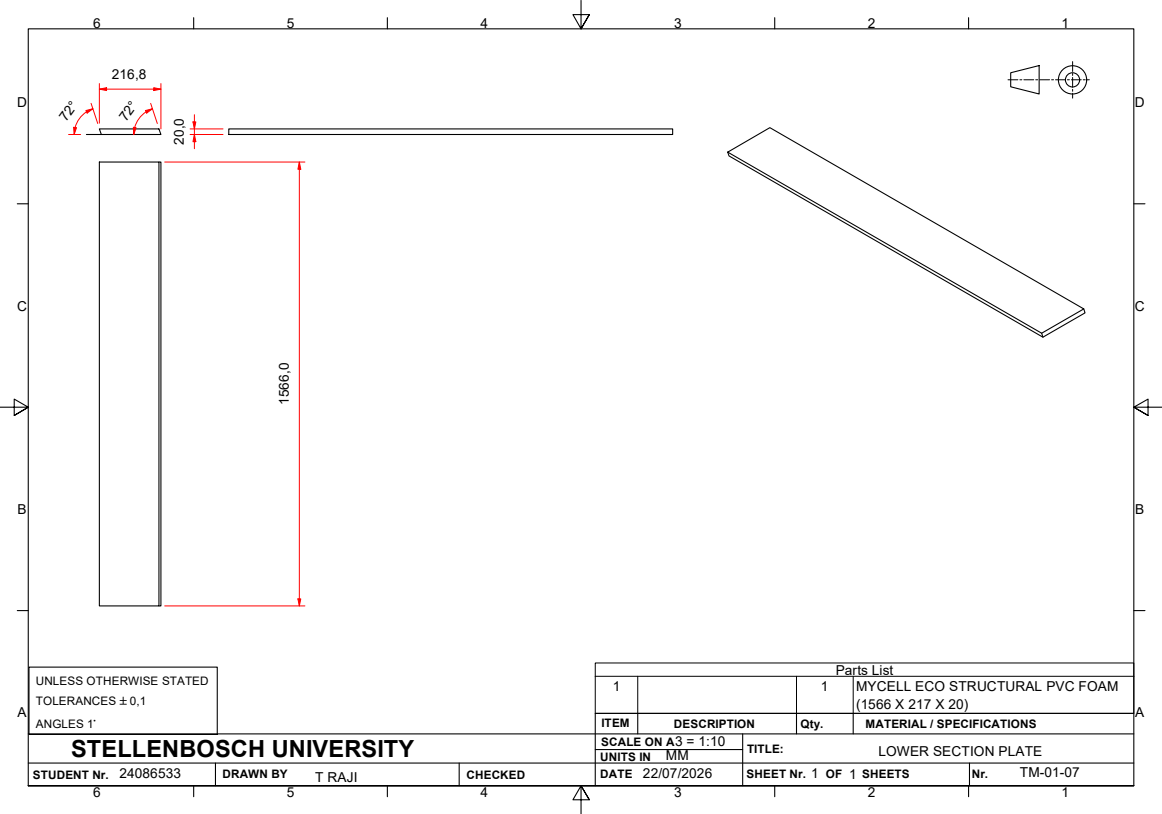
[picture p39: page 1]
Parts List; STUDENT Nr.; DRAWN BY; CHECKED; SCALE ON A UNITS IN; SHEET Nr.; SHEETS; T RAJI; LOWER SECTION PLATE

UNLESS OTHERWISE STATED
TOLERANCES `0,1
ANGLES 1~
STELLENBOSCH UNIVERSITY

1 | | 1 | MYCELL ECO STRUCTURAL PVC FOAM (1566 X 217 X 20)

ITEM | DESCRIPTION | Qty. | MATERIAL / SPECIFICATIONS
