Taiye24/Final-Year-Mechatronics-Project-478/CAD FILES/PIPE.pdf

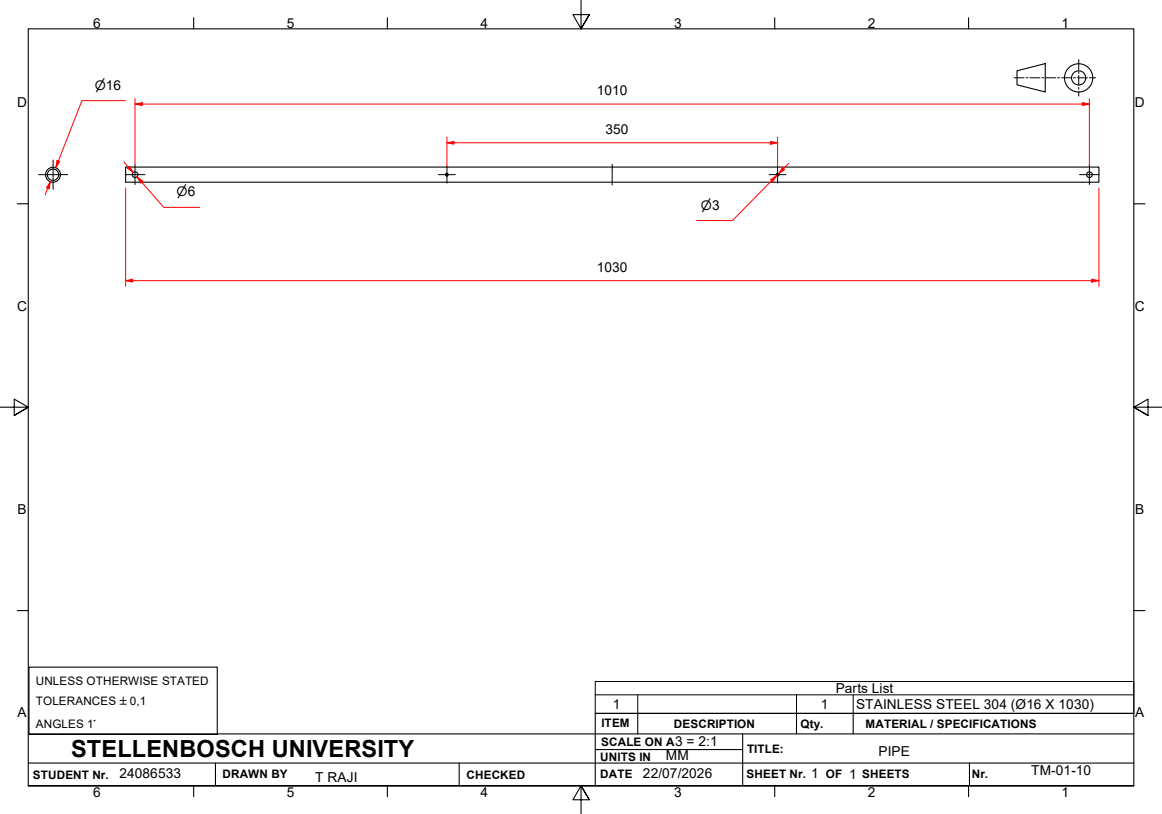
[picture p40: page 1]
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

UNLESS OTHERWISE STATED
TOLERANCES `0,1
ANGLES 1~
STELLENBOSCH UNIVERSITY

1 | | 1 | STAINLESS STEEL 304 (Ø16 X 1030)
ITEM | DESCRIPTION | Qty. | MATERIAL / SPECIFICATIONS
