Taiye24/Final-Year-Mechatronics-Project-478/CAD FILES/Rib 18mm.pdf

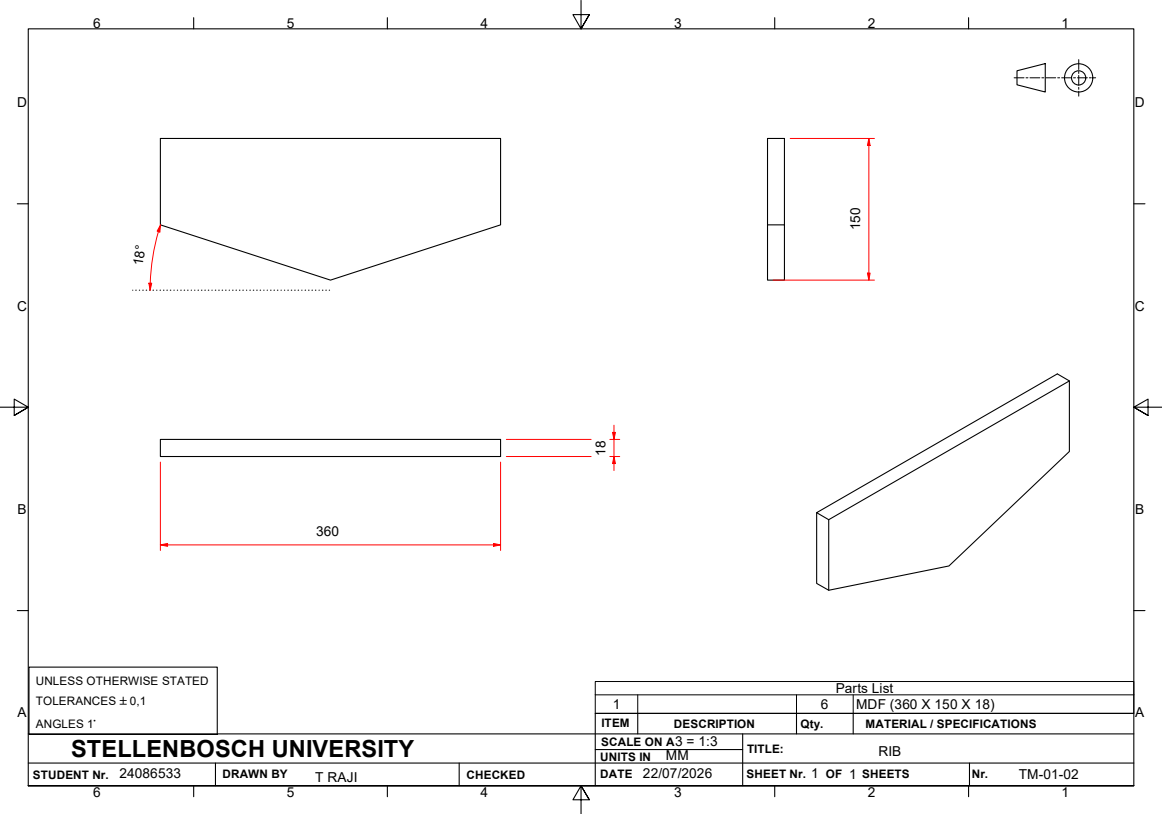
[picture p41: page 1]
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

UNLESS OTHERWISE STATED
TOLERANCES `0,1
ANGLES 1~
STELLENBOSCH UNIVERSITY

1 | | 6 | MDF (360 X 150 X 18)
ITEM | DESCRIPTION | Qty. | MATERIAL / SPECIFICATIONS
