Taiye24/Final-Year-Mechatronics-Project-478/CAD FILES/Rib 6mm.pdf

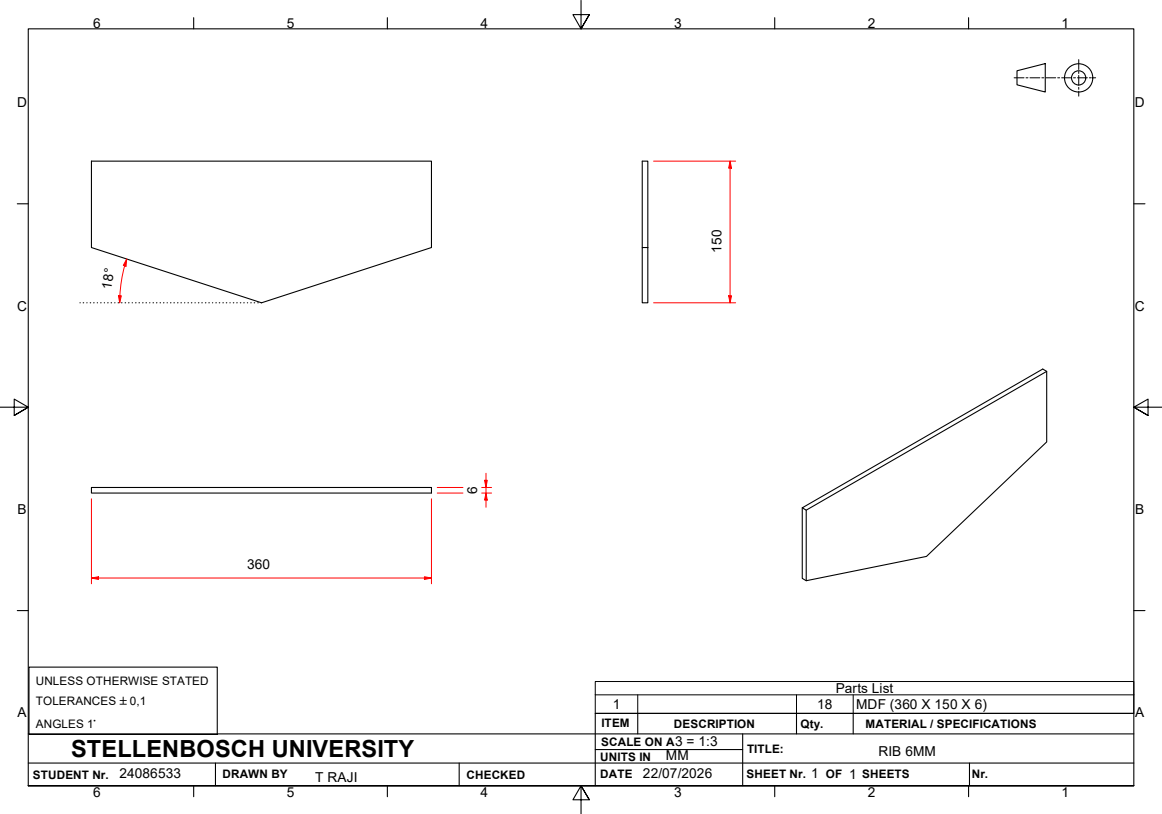
[picture p42: page 1]
Parts List; STUDENT Nr.; DRAWN BY; CHECKED; SCALE ON A UNITS IN; SHEET Nr.; SHEETS; T RAJI; RIB 6MM

UNLESS OTHERWISE STATED
TOLERANCES `0,1
ANGLES 1~
STELLENBOSCH UNIVERSITY

1 | | 18 | MDF (360 X 150 X 6)
ITEM | DESCRIPTION | Qty. | MATERIAL / SPECIFICATIONS
